benlorenzetti/Breadboard-Oven/Breadboard-Oven.tex

\documentclass[11pt, twocolumn]{article}
\usepackage[margin=1in]{geometry}
\usepackage{graphicx}
\usepackage{microtype}
\usepackage{verbatim}
\usepackage{amsmath}
\usepackage{nicefrac}
\usepackage[colorlinks=false, hidelinks]{hyperref}
\usepackage{caption}
\usepackage{subcaption}
\usepackage{listings}

\title{Report}
\author{Author}
\date{Septembre 2013}

% Definition of \maketitle
\makeatletter         
\def\@maketitle{
\raggedright
\\[8ex]
\begin{center}
{\Huge \bfseries \sffamily \@title }\\[4ex] 
{\Large  \@author}\\[4ex] 
\@date\\[8ex]

\end{center}}
\makeatother

\begin{document}

\maketitle

\section*{Features}

\section*{Introduction}

\section{User Interface}

\section{Oven Design}

\end{document}
