benlorenzetti/Breadboard-Oven/Easy-PCB.pdf

## Easy–PCB Solder Reflow Oven

Ben Lorenzetti

## Figures/easy-pcb-oven.pdf

## Features

- Insulated aluminum frame with XxYxZ interior chamber
- XXX Watt heating element with solid state relay control
- 120 VAC power supply with surge and short protection
- Forced convection fan driven by bipolar stepper motor with speed control
- Type X thermocouple for temperature feedback loop
- PIC18F14K50 based control
- Convenient 7–segment display and pushbutton user interface

## Introduction

Easy–PCB is a small, desktop convection oven for DIY reflow soldering at home.
As integrated circuits continue to become smaller and faster, many µControllers, FPGAs, and other ICs are no longer available in DIP form for breadboard prototyping or iron soldering. Similar to the shift away from PC parallel ports in the early 2000s, the shift away from DIPs means modern electronics hobbyists need more complicated equipment than their predessesors.
Currently, commercial solder reflow stations are available for soldering fine pitch, SMD, and BGA componenets. More recently, several hackers have created open source designs for inexpensive reflow ovens, using converted kitchen toaster ovens. Easy–PCB is better because it is a convection oven; controlled air flow prevents parts from being blown out of position and convection heating obviates the uneven heat absorbtion seen in infrared radiation based systems. Furthermore, Easy–PCB was designed from the ground up for soldering, so the heating elements and oven frame were optimized alongside the temperature controller for a typical solder reflow profile.

Figures/control-system.pdf

The Easy–PCB Control System: not just a controller bolted onto a disjoint oven.

Easy–PCB allows hobbyists to produce reflow temperature profiles with a high degree of accuracy and repeatability. Alongside freely available PCB design programs like Eagle and low-quantity fabrication services like OSH Park, Easy–PCB makes modern integrated components, such as digital CMOS cameras, within the design space of hobbyists and hackers.

Figures/control-results.pdf

Faithful Temperature Profile Control

## Contents

Features | 1
Introduction | 1
1 User Interface | 2
2 Plant Design | 2

2.4 Component Selection & SPICE Modeling 7

3 Temperature Feedback Design | 8
3.1 Controller and Power Requirements . | 9
4 Motor Driver Design | 9
5 Power Circuit Design | 9
6 Controller Design | 9

## 1 User Interface

Easy–PCB presents temperature and time information on a four digit LED display. After pressing the green ‘start’ button, the current temperature and process runtime are alternately displayed every second.

The red ‘stop’ button can be pressed at anytime to quit the current process or reset the microcontroller.

← | →

↑

↓

Start

Stop

Pushbutton Interface

Set point programming with the 4 nav keys is used to enter a time–temperature profile. Use the ‘left’ and ‘right’ keys to move between set points and the ‘up’ and ‘down’ keys to edit each set point value.

0s | 20o | t1 | T1 | t2 | T2 | tn | 20o
| | | | | 275oC

20oC

(tn−1 + 255s)

tn−1

t1 | t2 | tn

T1

T2

T (

oC)

time (s)

Set Point Programming

A total of 128 set points can be entered. The first set point is always (0s, 20oC), and the process will terminate at the next occurance of 20o
in a
point. Temperatures can take any value in the range 20oC < T < 275oC = 527oF. The time between two points must be between 0 <= t < 255 seconds.

## 2 Plant Design

### 2.1 Temperature Objectives

A typical solder reflow profile is shown in figure 1. The optimal shape and peak temperature depend on the components and, more significantly, on the use of

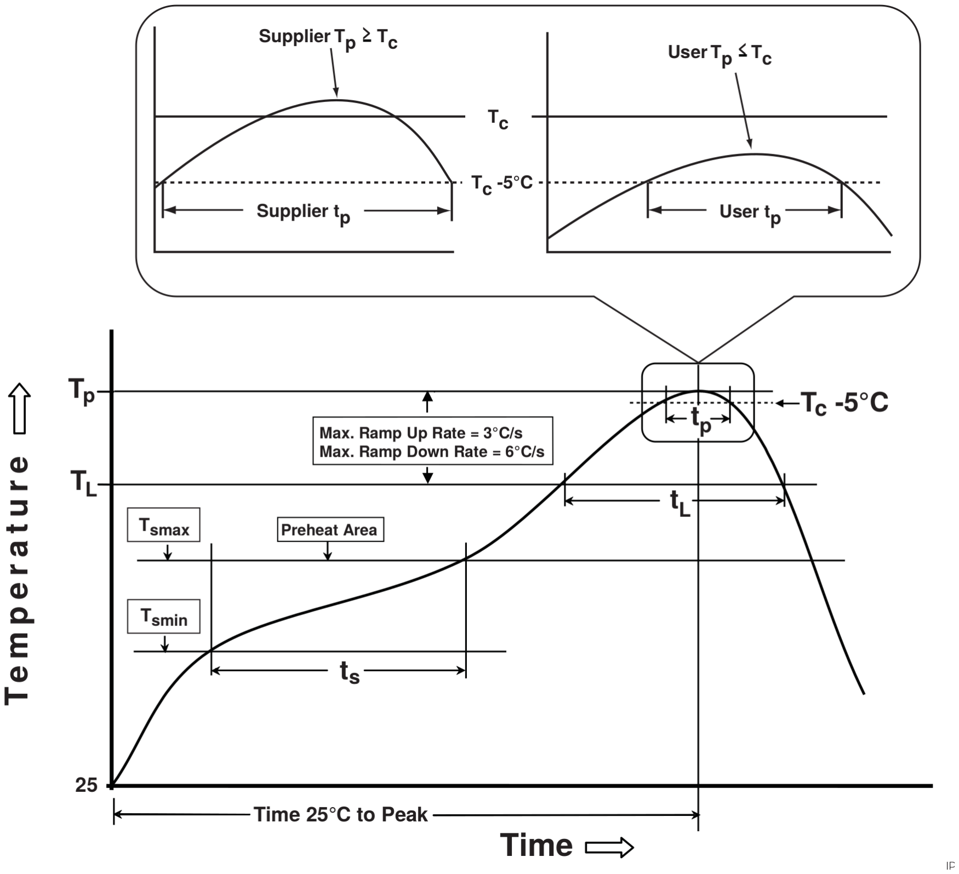
[picture p2: figure]

Figure 1: Standard Solder Reflow Profile, per IPC/JEDEC STD-1-020D.1

leaded solder.

Tp ≈ Tc =

220 − 235oC Leaded solder
245 − 260oC Pb–free

tp =

20s Leaded solder
30s Pb–free

Easy–PCB was designed from the ground up for faithfully producing these reflow profiles. This design process for the thermodynamic system is detailed below.

### 2.2 Thermodynamics Theory

Heat is everyone’s least favorite form of energy because it tends to dissipate everywhere and is difficult to transform into useful work. Nevertheless, it is a form of energy so it is measured in joules.

Q := Heat [Joules]

From a microscopic view, heat is the kinetic energy of gas molecules or the vibrational energy of bonds in solids. In both cases, summed over every molecule, every bond, and every vibrational mode in the system.

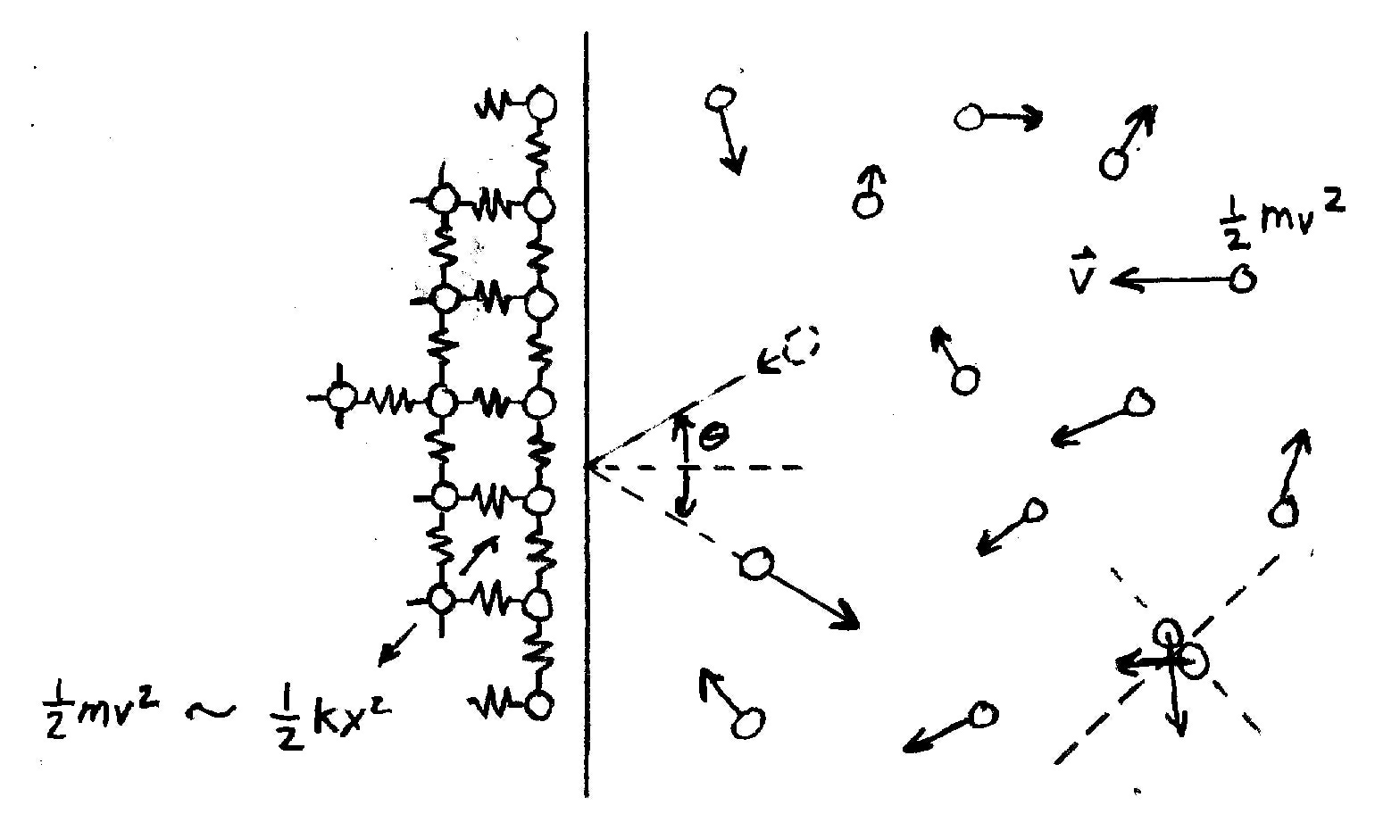
[picture p3: figure]

Figure 2: Heat Energy on a Molecular Scale

Temperature is a potential field that measures an objects tendancy to give up or absorb heat. On average, heat always flows from regions of hotter temperature temperature to lower temperature. Temperature is usually measured in Kelvin or Celsius, which are related by

TCelsius = TKelvin + 273.16.

Another way to think of temperature is a measure of heat density that also incorporates the types of bonds (or lack thereof) in which heat energy is stored.

For example, a glacier contains more heat than a pot of boiling water, but has a much lower heat density. The relationship between temperature and heat stored in an object is given by

dQ = mcpdT, | (1)

where cp is the specific heat of the material with units
h
kJ
kg∗K

i
So heat flows spontaneously to reduce temperature gradients, but how does heat flow and at what rate? There are three mechanisms of heat transfer: conduction, convection, and radiation.
Conduction of heat is caused by molecular interactions, such as the push–pull of nearby atomic bonds in solids or elastic collisions between molecules of air. The empirical relation for conduction is Fourier’s Law, which says the rate of heat transfer due to conduction is proportional to both the difference in temperature and the media:

~q = k∇~ T

where ~q is the rate of heat transfer per unit surface area and k is the thermal conductivity of the medium with units -

W
m∗K
In integral form, Fourier’s Law is

δQ
δt = k

I

S

∇~ T ∗ dA. ~

And, in the one dimensional case,

δQ
δt = −kAδT
δx . | (2)

Convection is the second mechanism of heat transfer, involving the bulk movement of particles driven by diffusion.
Every air molecule is moving in a random direction with random kinetic energy, but a region of air with higher average kinetic energy (temperature) will see more molecules leaving than entering on average, because those leaving are moving faster than those entering.
Note that in convection, no molecules gain or lose energy; molecules of different energy simply trade places.
If a fan is used to apply work to a gas, the rate of convection increases and then Newtons’ Law of Cooling can predict the rate of convection in gas near a solid surface of different temperature.

dQ
dt = hA∆T | (3)

where h is the heat transfer coefficient with units -

W
m²∗K

Radiation, the third mechanism of heat transfer, is more familiar to electrical engineers. In any material, electrons have discrete amounts of energy based on the wave patterns that can exist for the atomic geometry. When an electron spontaneously falls to a less energetic patter, that energy is emitted as a photon of light.

The classic, physics–history example is black body radiation, when a metal is heated to high temperature and glows. A more modern examle is the LED.

The empirical relation for radiation is the Stefan– Boltzmann Law, which says that the total energy radiated, over all wavelengths and per unit surface area, is proportional to the fourth power of the body’s temperature.

j

∗ = σT⁴
(4)

where σ is a proportionality constant derived from other constants of nature.

Mechanisms & Media Usually one mechanism of heat transfer is dominant in a particular medium, so much so that we can ignore the other two. Typically this means conduction in solids, convection in fluids or gas, and radiation in space. However, sometimes the picture is more complicated including two cases in an oven:

1. At the boundary of metal and air, where conduction and convection are both significant.
2. In a thermocouple loop, where thermal diffusion (convection) of electrons is useful despite conduction still being dominant.

### 2.3 Thermodynamic Design

Most microwaves draw between 600 and 1200 Watts of power. An IR toaster oven may draw 1500 Watts into its lamps. How much power does Easy-PCB need to produce the required temperature profiles?

Our approach for answering this question is to browse available parts on McMaster.com, imagine how they would be assembled into an oven, and then model their thermodynamic response using SPICE.

A first conceptual design of Easy–PCB is shown in figure 3.

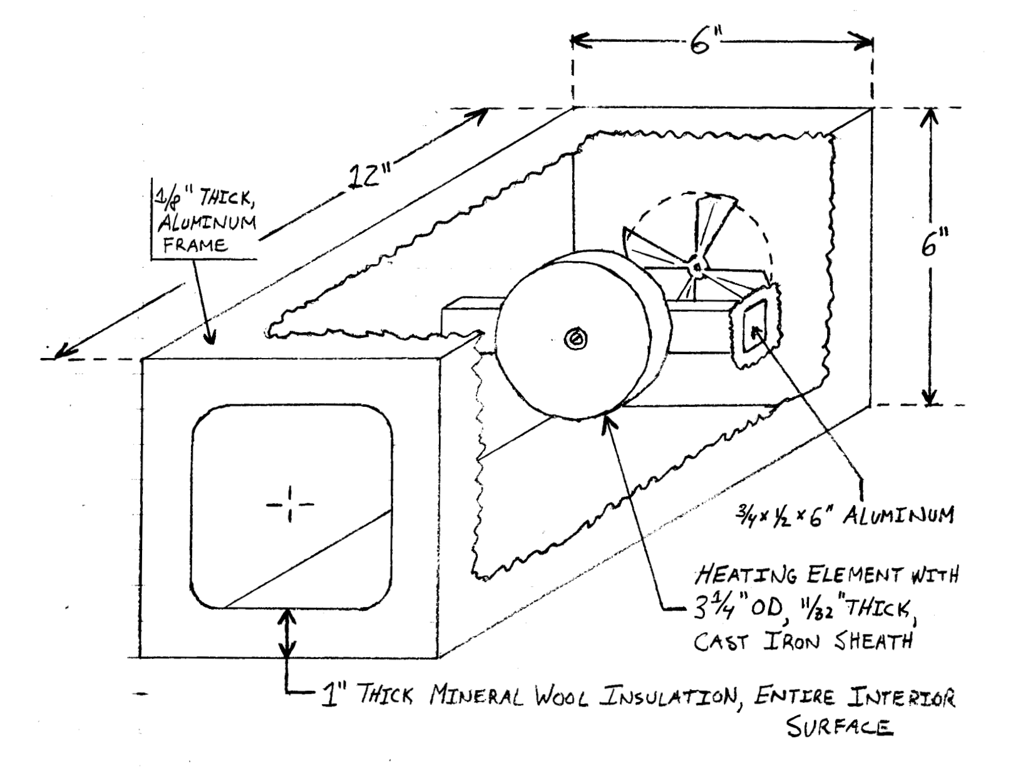
[picture p4: figure]

Figure 3: Concept for Thermodynamic System

Conduction through Metals & Insulation

In the concept, the oven chamber is isolated from the outside with walls of mineral wool insulation and aluminum. If the wall is relatively thin compared to the square root of its surface area, then its heat transfer can be modeled as a 1–D transmission line, like shown in figure 4.

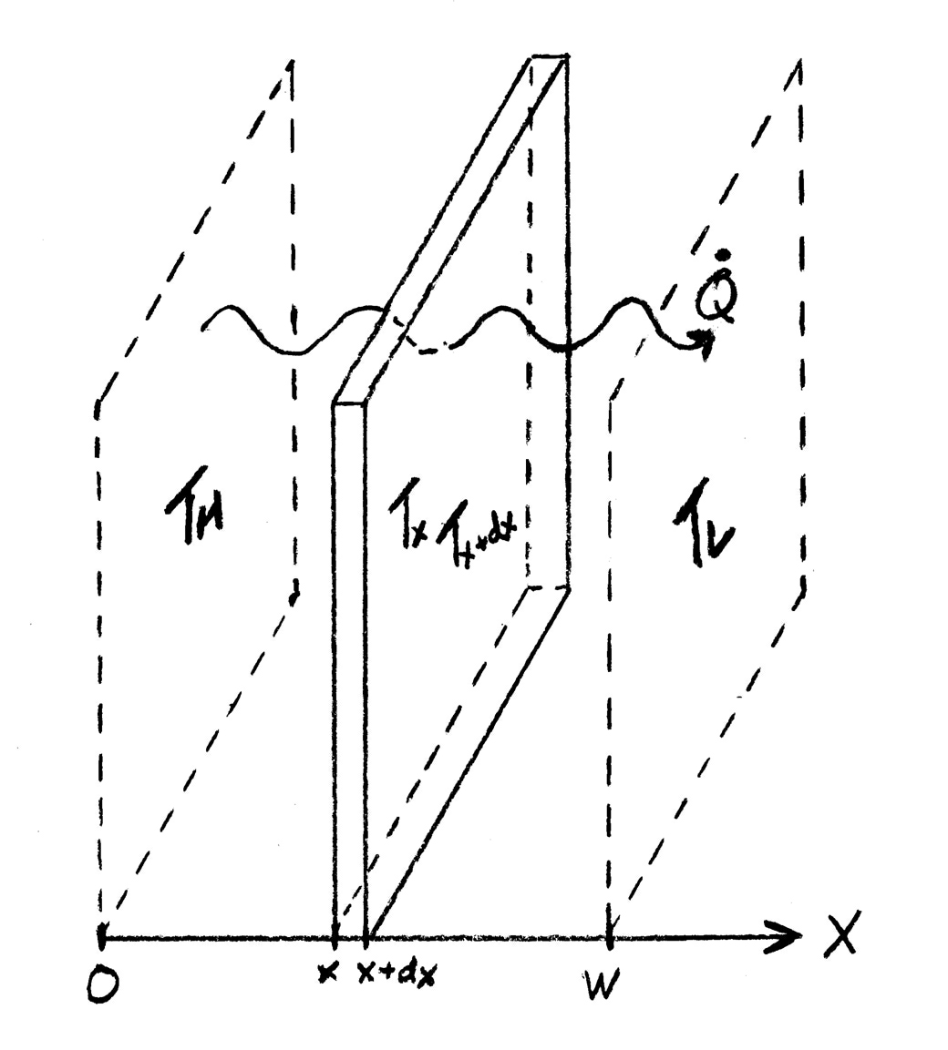
[picture p5: figure]

Figure 4: Heat Conduction in 1–D

Assuming conduction is the dominant mechanism of heat transfer and using Fourier’s Law in 1–D, (equation 2) the rate of heat passing through a thin slice is
δQ
δt = −kAδT
δx

And, from equation 1, the heat capacity of a thin slice of the metal sheath is

dQ = (ρAdx)cpdT

Rewriting these equations to look like currentvoltage relationships gives

δT = Rx

δQ
δt , Rx =

δx
| kA | (5)

and
δQ
δt = Cx

δT
δt , | Cx = ρAcp ∗ δx | (6)

Values for thermal conductivity k, specific heat capacity cp, and density ρ of different materials are listed in table 1.
Long metal bars and rods can also be modeled with equations 5 and 6 if the heat loss along the length of the bar is assumed to be negligible compared to heat transfered at the end faces.

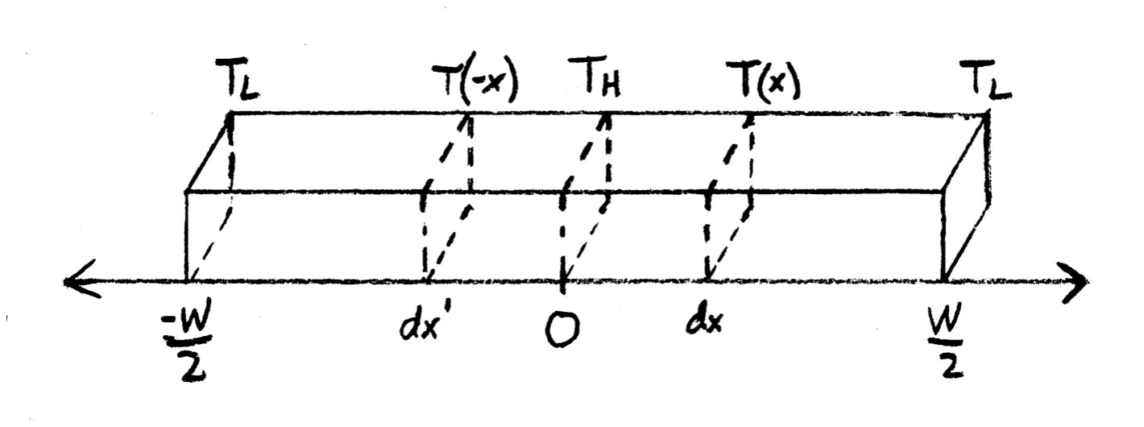
[picture p6: figure]

Figure 5: 1–D Conduction in Both Directions

For metal components where heat is injected at the center of the part and dissipates symmetrically in either direction, such as the support bar shown in figure 5 or the metal sheath encasing the heating element, the surface area can be doubled so that the transmission line only needs to be integraded in the positive direction.

Ax | ⇒ | 2Ax
Rx | ⇒ | Rx/2
Cx | ⇒ | 2Cx
{x| − w
2 ≤ x ≤

w
2

} ⇒ {x|0 ≤ x ≤

w
2

}

(7)

Conductivity of Metal–Air Interface

In the bulk volume of air, convection is the dominant form of heat transfer and collisions are relatively rare. However, where the air meets a solid surface, the net convection must go to zero because there can be no net movement of air molecules into the solid. Furthermore, every air molecule that reaches the surface experiences a collision so there is 100% conduction at the surface. For some distance away from the surface, there is a larger than normal chance of head–on collisions and slower rates of diffusion due to the nearby wall. In

Table 1: Thermal Conductivity, Specific Heat, and Density of Selected Materials

Material | Linear Range (oC) | k

W
m∗K
cp
kJ
kg∗K
ρ (kg/m³
)
Type 6061 Aluminum | 25 | 167 | 0.896 | 2700
Type 304 Stainless Steel | 0–100 | 16.2 | 0.5 | 8000
Cast Iron | 25 | 55.0 | 0.46 | 6800–7800
1.0 K–factor Insulation | - | 0.1442 | - | -
0.23 K–factor Insulation | - | 0.0332 | - | -
Nichrome NiCr C Alloy | - | 0.450 | 0.135 | 8244

this region, both conduction and convection may be significant. To analyze this transition region, we will start at the surface where there is 100% conduction because that is the mechanism we have equations for. From the first law of thermodynamics, the rate of heat being stored in a differential volume is equal to the rate of heat entering less the rate of heat leaving the volume element.

δQstored
δt =

δQin
δt −

δQout
δt

Looking back at figure 4, the differential volume element is a plane, so

δQstored
δt =

δQx
δt −

δQx+δx
δt .

Substituting in equation 1 for stored heat capacity and equation 2 for conduction through the element yields a transport equation.

mcp

δT

δt = kAδT
δx | (8)

This cannot be solved analytically unless space and time are independent. Sorry Albert.

T(x , t) = Tx(x) ∗ Tt(t) | (9)

Applying the chain rule to equation 8

mcp

δTt(t)

δt Tx(x) = kAδTx(x)
δx Tt(t)

and separating variables gives

mcp

δTt(t)
δt ∗

1
Tt(t)

= kAδTx(x)
δx ∗

1
Tx(x)

The only way for the equality to be true for all space and time is if both sides are equal to a common constant.
α = mcp

δTt(t)
δt ∗

1
Tt(t)

α = kAδTx(x)
δx ∗

1
Tx(x)

Each of these can be solved by separation of variables.
α
kAδx =

δTx(x)
Tx(x)

α

kA Z
δx =

Z
1
Tx(x)

∗ δTx(x)

αx
kA = ln (Tx(x)) + β1

Tx(x) = β

0
1

e

αx/kA

Similarly for time,

Tt(t) = β

0
2

e

αt/mcp

Recombining the independent components gives

∆T(x , t) = β

0
1β

0
2

e

αx/kA+αt/mcp

The boundary conditions are that at t = 0 and x = 0, the temperature difference is the initial temperature difference, and at t → ∞ and x → ∞, the temperature difference dissipates to zero.

∆T(x , t) = ∆T0e

−αx/kA−αt/mcp

Now, for the sake of physical intuition we can write

∆T(x , t) = ∆T0e

−(x/δ+t/τ)
, | (10)

where δ is a ‘skin depth’ over which the spacial gradient decays to 1/e its initial value and τ is a time constant related to the skin depth by

τ =

mcp
kA δ. | (11)

Make some arguments and plot the temperature and heat transfer curves. Assume steady state and somehow that active cooling makes it all valid. Applying Fourier’s law to the temperature profile found in equation 10, gives us the rate of heat trasfer in the air due to conduction.

dQ
dt = −kAdT
dx =

kA
δ

∆T0e

−(x/δ+t/τ)

Table 2: Typical Convective Heat Transfer Coefficients

| Fluid | Conv. | hc - W m²∗K
Gases, & dry vapors | free | 0.5 − 1000
| | forced | 10 − 1000
Water & liquids | free | 50 − 3000
| | forced | 50 − 10000
Boiling Water | - | 3 − 100
Condensing H2O Vapor | - | 5 − 100

Table 3: Thermal Properties of Air

T [

oC] ρ

h
| kg m³

i
cp

h
| | kJ kg∗K

i
| | | k - W m∗K
20 | 1.205 | 1.005 | 0.0257
40 | 1.127 | 1.005 | 0.0271
60 | 1.067 | 1.009 | 0.0285
80 | 1.000 | 1.009 | 0.0299
100 | 0.946 | 1.009 | 0.0314
120 | 0.898 | 1.013 | 0.0328
140 | 0.854 | 1.013 | 0.0343
160 | 0.815 | 1.017 | 0.0358
180 | 0.779 | 1.022 | 0.0372
200 | 0.746 | 1.026 | 0.0386
250 | 0.675 | 1.034 | 0.0421
300 | 0.616 | 1.047 | 0.0454

Again assuming steady state, the rate of heat trasfer at any distance from the wall is equal to the rate of conduction at the wall.

dQ
dt =

kA
δ
∆T0 = hcA∆T0 | (12)

This is the information we were after and, ironically, it turns out this is Newton’s Law of Cooling (equation
3) where hc = k/δ. Since we do not have any way of predicting the skin depth except by experimentation, some common values for the convective heat transfer coefficient hc are listed in table 2.
Equation 12 can be rewrittent to look like Ohms’ law for SPICE analysis.

∆T = Rc

dQ
dt , Rc =

1
hcA

=

δ
kA (13)

Heat Capacity of Chamber Air

The heat capacity of the air in the chamber cannot be analyzed with constant coefficient assumptions.

dQ = m(T)cp(T)dT | (14)

From table 3, we can see that the specific heat of air does not vary much over the temperature range of the oven; less than 0.3% from cp(20oC) over the range

20 − 300oC. However, the density and mass of air in the chamber may change significantly.
Assuming that the air in the chamber behaves like an ideal gas and is made up of the normal percentages of N2, O2, CO2, etc., then mass and temperature are related by

P V =

m
M
RT | ⇒ | m(T) = MP V R
T

where the ideal gas constant is

R = 5.00745

| | atm ∗ in³
| | mol ∗ K

and the molar mass of air is

M = 28.97 h

g
mol

i

For the first oven concept in figure 3, the volume of the chamber is fixed in natural units of in³ and there are likely small leaks that let the chamber pressure equilibrate to atmospheric pressure 1 atm. Substituting m(T) into equation 14, converting from absolute Kelvin scale to Celsius, and manipulating to look like a current–voltage relationship results in
dQ
dt = Cc(T)

dT
dt | (15)

where
Cc(T) = cp(20oC)MP V
R(T + 273.16oC)
. | (16)

Equivalently,

Cc(T) =

5.8143 -

J
in³

∗ V
T + 273.16oC

### 2.4 Component Selection & SPICE

Modeling

Unfortunately, SPICE does not have a primitive circuit element for a variable capacitor. In order to simulate the heat capacity of an ideal gas, we must build a subcircuit that behaves according to

ic = C(vc)

dvc
dt ,

or, alternatively,
Z
icdt =

Z
C(vc)dvc. | (17)

The interface of the SPICE circuit will be a dependent source where either vc is dependent on ic or vice versa.
The left side of equation 17 is an integrator, which can be implemented with a buffer and a capacitor. For the SPICE circuit shown in figure 6, the integrated current is proportional to the voltage of the ‘int’ node.
Z
icdt = Cint ∗ vint

Figures/variable-capacitance-circuit.pdf

Figure 6: Voltage Variable Capacitor in SPICE

For the right side of equation 17, it can be solved for the variable heat capacitance of an ideal gas found in equation 16.
R
C(vc)dvc =

cpMP V
R

R

dvc
vc+273.16
| =

cpMP V
R

ln(vc + 273.16) + A

Recombining the left and right halves gives

Cintvint =

cpMP V
R

ln(vc + 273.16) + A,

which can be solved to find a nonlinear expression for a dependent source vc.
Solving...

RCint
cpMP V

∗ vint = ln(vc + 273.16) + A

vc = A

0
e

vint/B − 273.16

Finally, applying boundary conditions vc(0) = 0 and vint(0) = 0 gives

vc = 273.16
e

vint/B − 1

(18)

where constant B is

B =

cpMP
R

∗ V ∗ Cint

=

5.8413 -

J
in³

∗ V ∗ Cint

(19)

and V is the constant volume of air.

Table 4: Nichrome Wire Properties (NiCr C)

Composition | 59.2%Ni | 16%Cr | 23.5%Fe | 1.3%Si
Resistivity (ρ) | 675 ∗ π

h
| | Ω∗mil²
f t | i
Melting Pt. | 1350 | [ oC]
Temp. [oC] | 20 | 93 | 204 | 315
% ρ Increase | 0 | 1.7 | 3.5 | 5.2

### 2.5 Transfer Model

## 3 Temperature Feedback Design

The Seebeck voltage is the electromotive force that develops in a conductive loop made of two different metal alloys. It is described by

| ES =

Z T

| T R
αA,BdT, | (20)

where T and TR are the temperatures of the hot and cold junctions and αA,B is the Seebeck coefficient between materials A and B.
A type–K thermocouple was selected because they are readily available and resist oxidation at temperatures up to 1260oC. From the ‘Manual on the use of Thermocouples in Temperature Measurement’ (STP 470A), the nominal Seebeck coefficients for type– K thermocouples is

αKP,KN =

0

oC 39.4 µV /oC
200oC 40.0 µV /oC
400oC 42.3 µV /oC

. (21)

The positive wire KP is one of the following alloys: Chromel, Tophel, T–1, or ThermoKanthal KP. The negative wire KN is Alumel, Nial, T–2, or ThermoKanthal KN.
The thermoelectric potential in a K loop is very small; for a temperature difference of T −TR = 500oC, the voltage developed is only on the order of ES = 20 mV . Consequently, the signal needs to be amplified before it can be read by and ADC. The op amp circuit shown in figure 7 can be used.
Five volt µcontrollers usually have ADC ranges of 0–3.3 V. To scale 20 mV to 3.3 V and 0 V to 0 V , the feedback resistors should be

VADC(max)

VK(max)

=

R2
R1

(22)

3.3 mV
20 mV

= 165

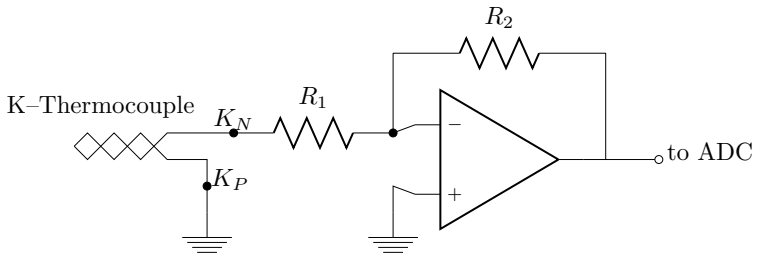
[picture p7: figure]
to ADC; K–Thermocouple

Figure 7: Thermocouple Amplifier

### 3.1 Controller and Power Require-

ments

## 4 Motor Driver Design

### 4.1 Power Requirements

## 5 Power Circuit Design

### 5.1 PCB Trace Width

The minimum width and clearance for high current, high voltage traces on a PCB can be calculated using

I = 0.048[A] ∗

∆T
[

oC]

0.44
∗
A
[mil²]

0.725
(23)

and

Clearance = 0.023[in] + 0.0002[in]
[V ]

∗ Vpeak (24)

from the design standard for PCB trace width ANSI/IPC–2221. Note that equation 23 is only for exterior traces.
For 10 A, 120 V AC power with a maximum temperature rise of 10oC and standard copper thickless 1 oz = 1.4 mil, the minimum trace width is 0.278 in and minimum clearance is 0.057 in.

## 6 Controller Design
