benlorenzetti/Breadboard-Oven/Figures/aluminum-frame-concept.pdf

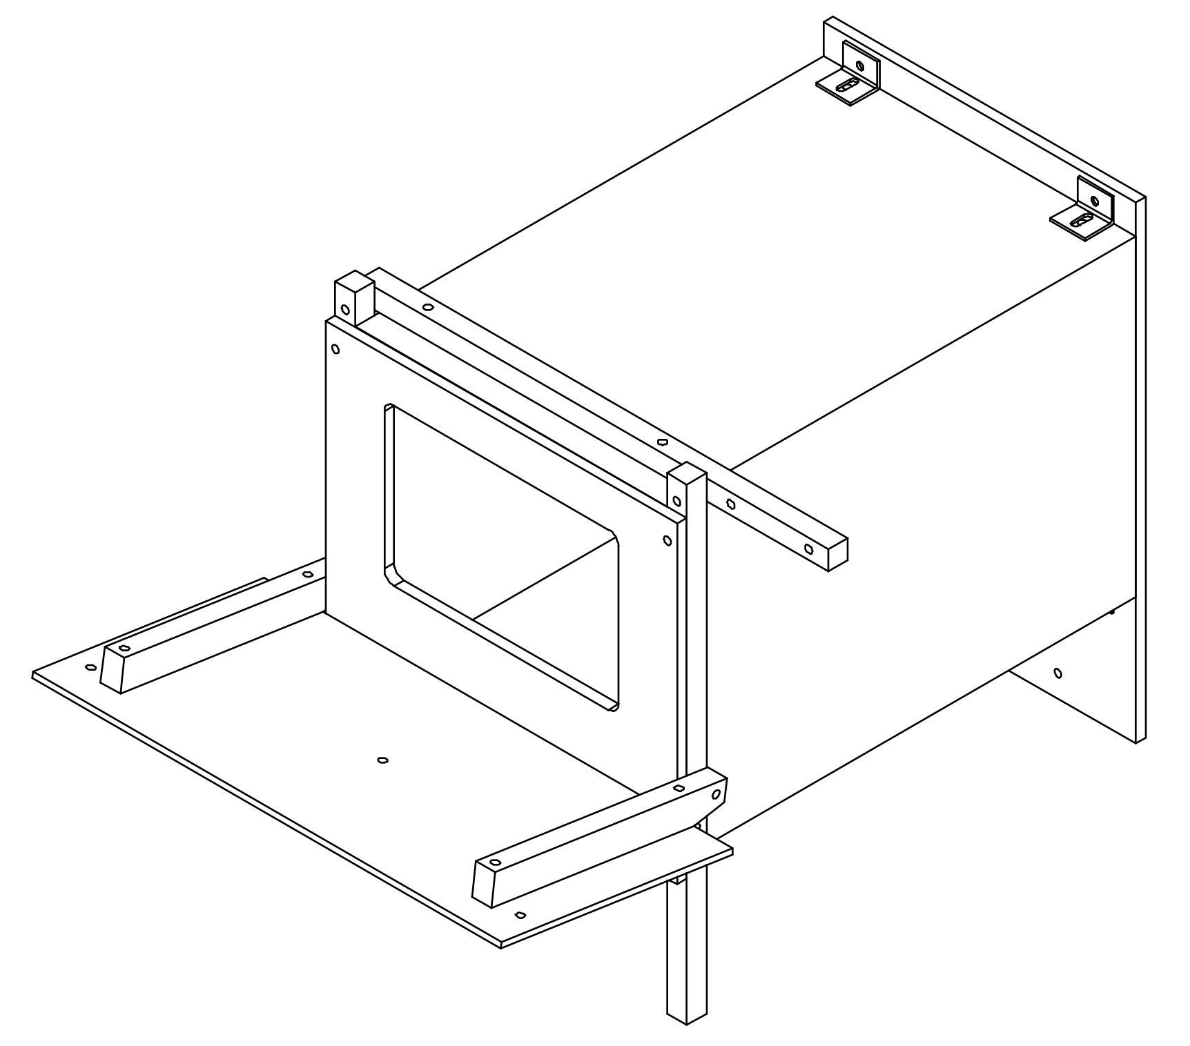
[picture p8: page 1]
