benlorenzetti/Breadboard-Oven/Figures/heating-element-concept.pdf

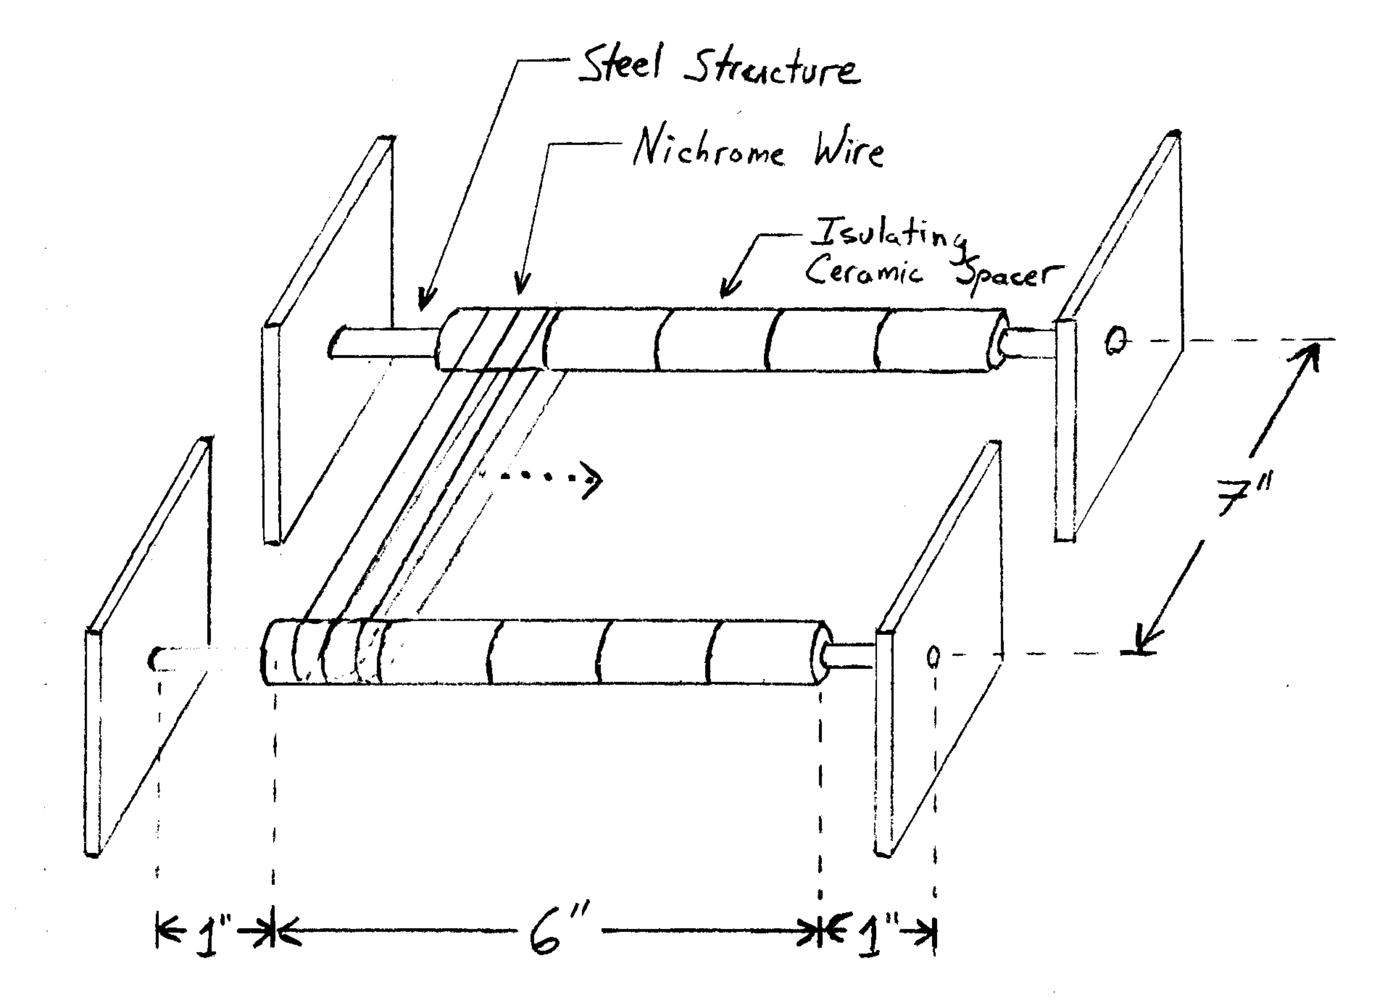
[picture p9: page 1]
