benlorenzetti/Breadboard-Oven/Figures/pic16f883-circuit.pdf

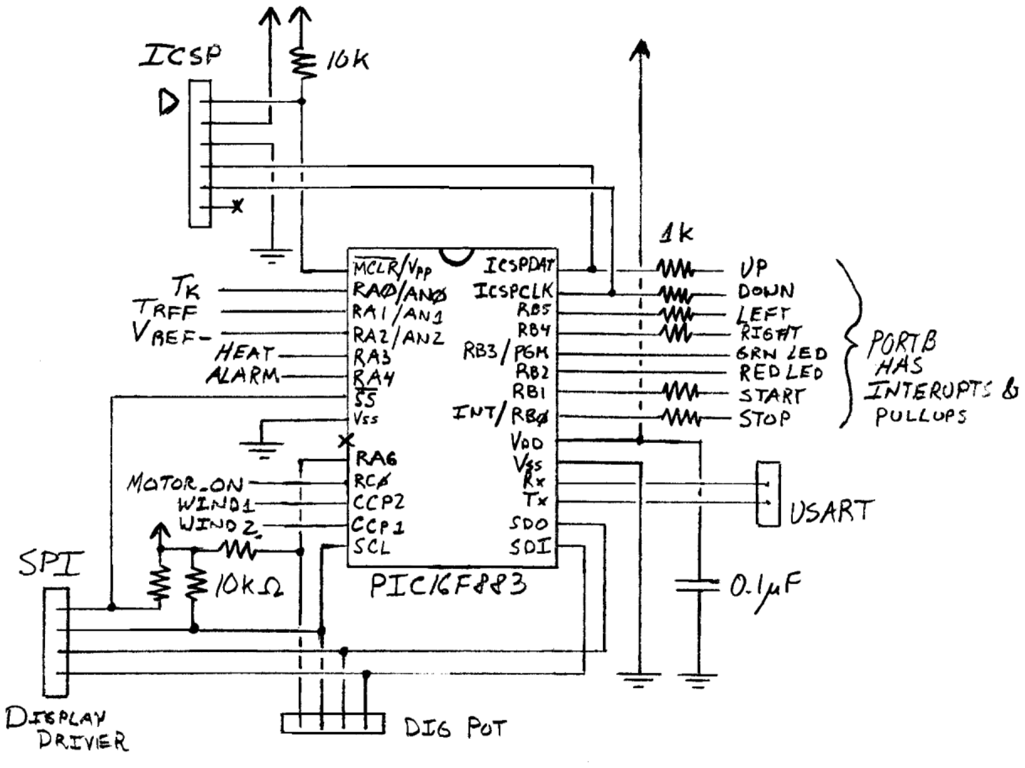
[picture p10: page 1]
