benlorenzetti/Breadboard-Oven/Figures/pushbutton-circuit.pdf

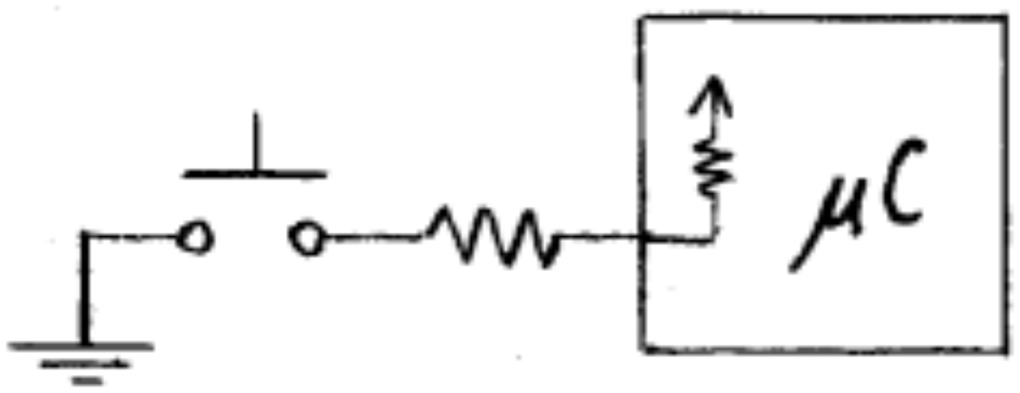
[picture p11: page 1]
