benlorenzetti/Breadboard-Oven/Figures/control-system.pdf

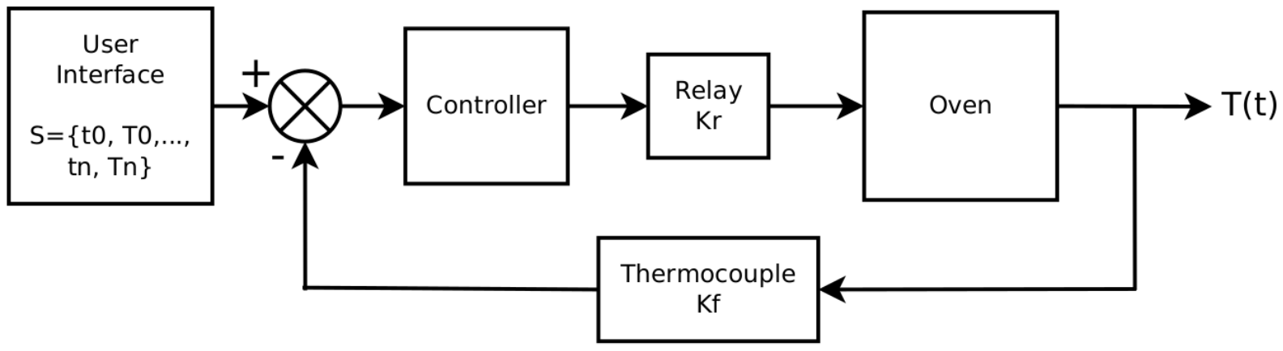
[picture p12: page 1]
