benlorenzetti/Breadboard-Oven/Figures/motor-driver-circuit.pdf

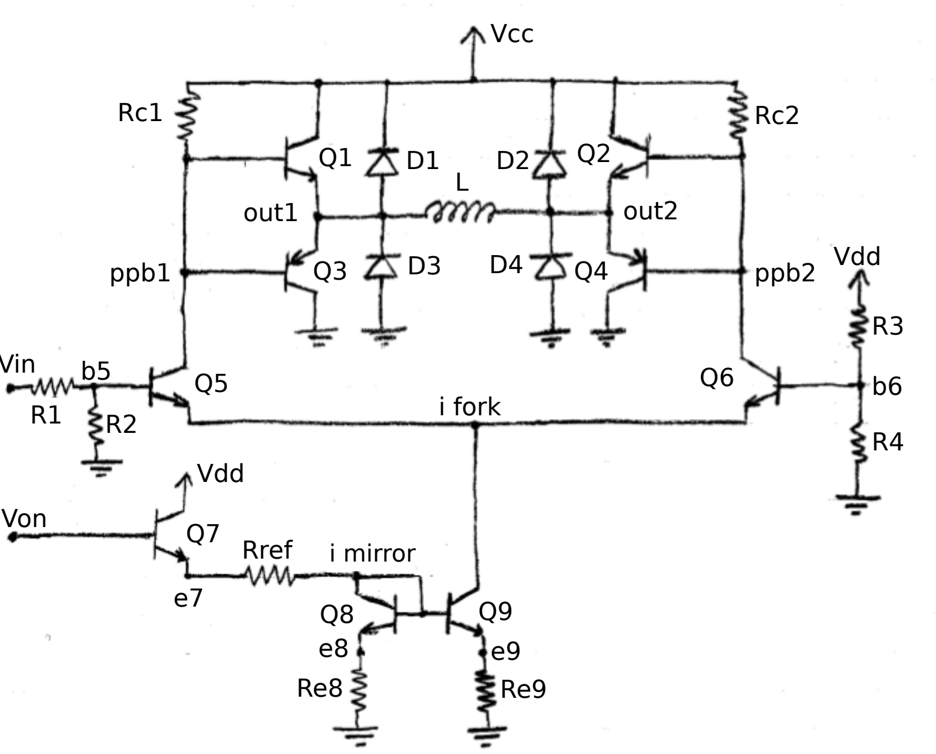
[picture p13: page 1]

Rc2

ppb2

Q6 | b6 R3

Vdd

R4

Q5 b5
R2 R1

Vin

Von | Q7

Vdd

Rref | i mirror
Q8 | Q9
e8

e7

e9
Re8 | Re9

Vcc

out1 | out2

i fork

L

D1 | D2
D3 | D4

Q2

Q3 | Q4

Q1

ppb1

Rc1
