benlorenzetti/Breadboard-Oven/Figures/thermocouple-amplifier.pdf

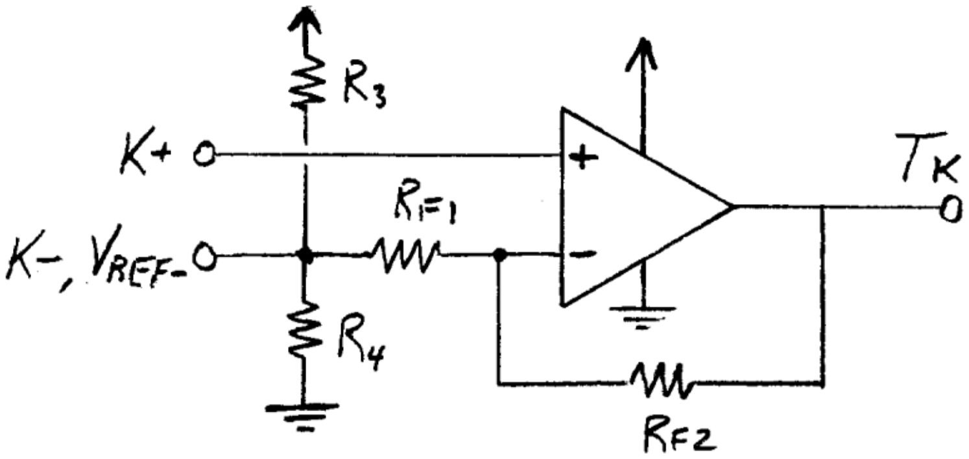
[picture p14: page 1]
