benlorenzetti/Breadboard-Oven/Figures/relay-drive-circuit.pdf

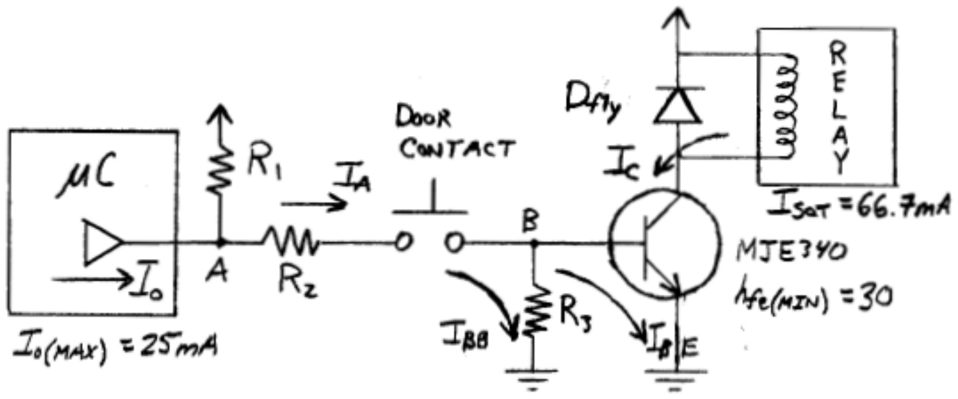
[picture p15: page 1]
