benlorenzetti/Breadboard-Oven/Figures/control-flowchart.pdf

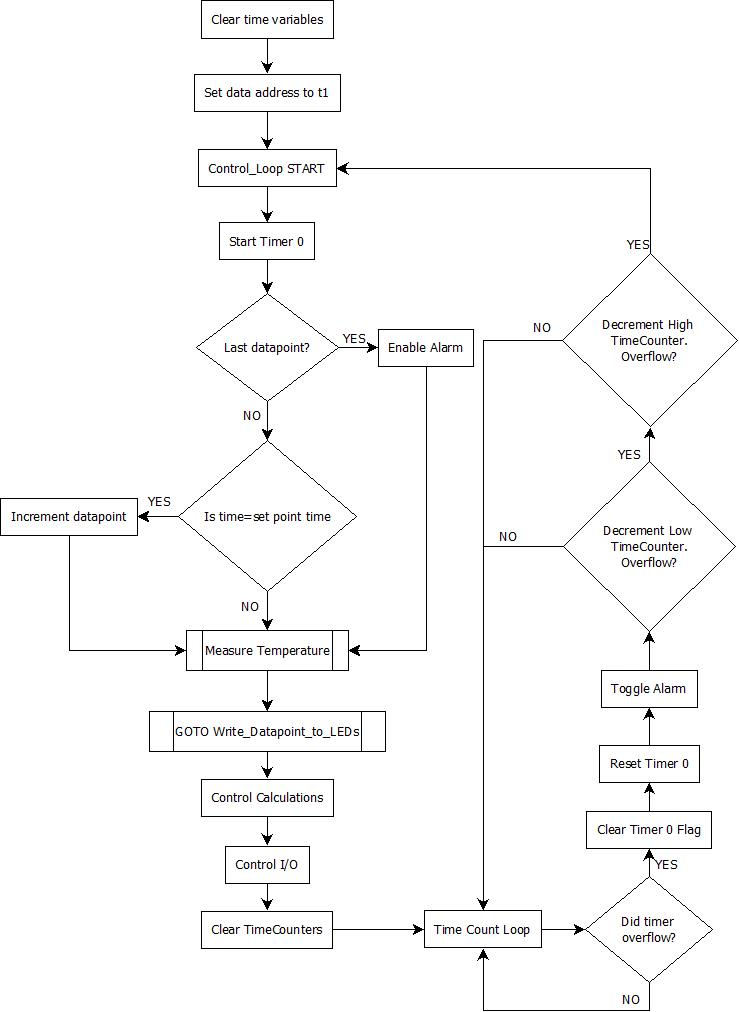
[picture p16: page 1]
