benlorenzetti/Breadboard-Oven/Figures/user-interface-flowchart.pdf

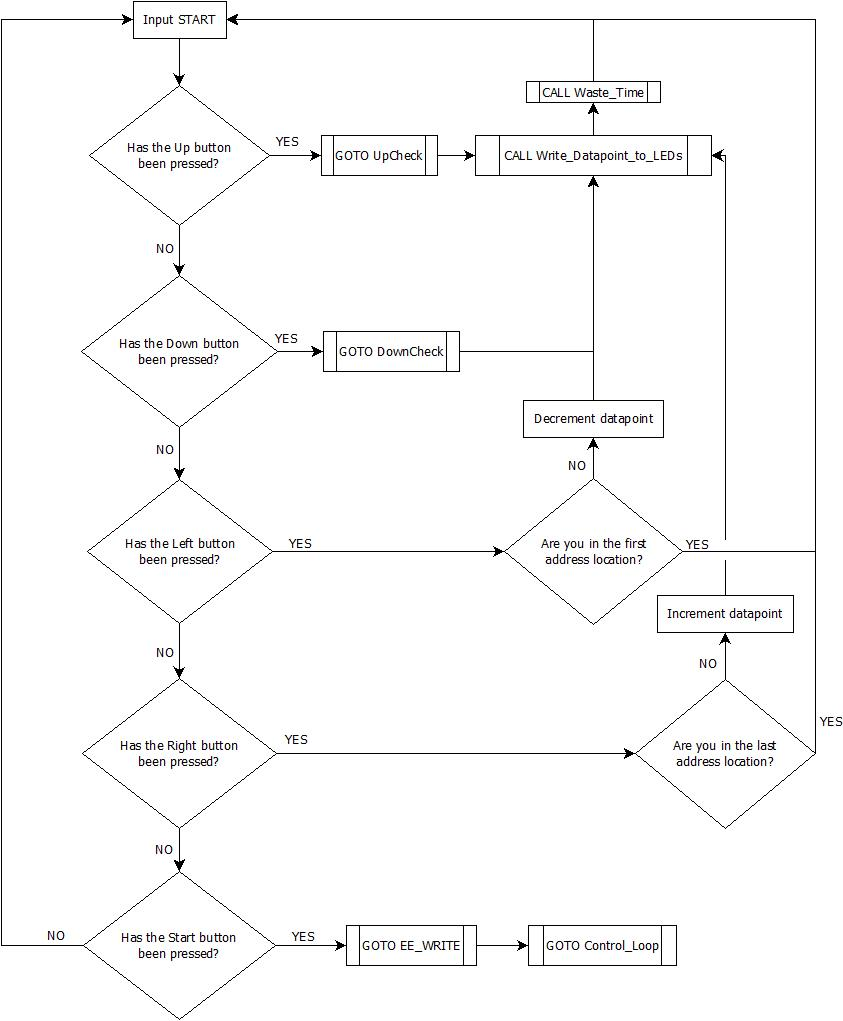
[picture p17: page 1]
