benlorenzetti/Breadboard-Oven/Figures/thermodynamic-spice-circuit.pdf

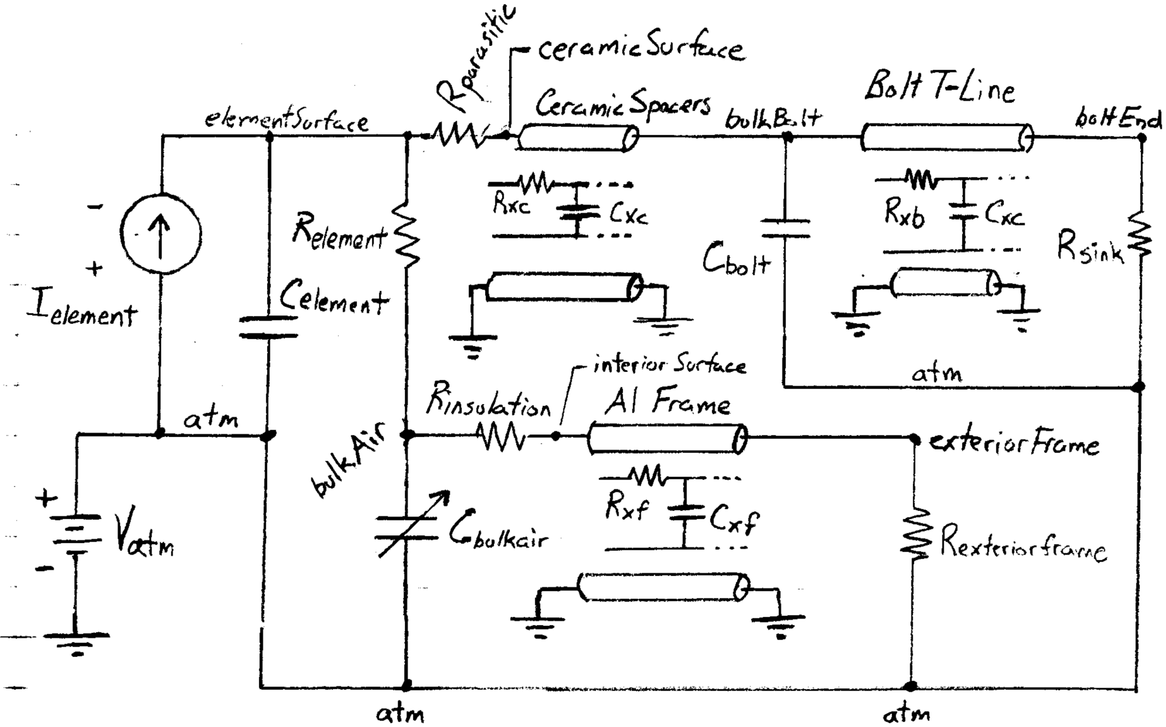
[picture p18: page 1]
