benlorenzetti/Breadboard-Oven/Figures/bipolar-motor.pdf

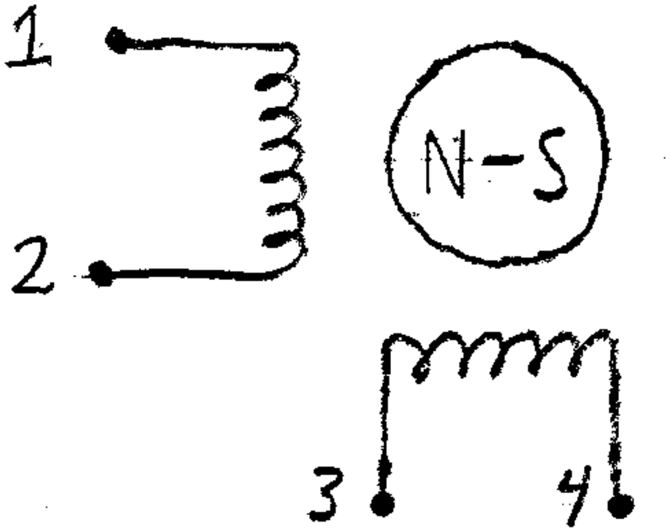
[picture p19: page 1]
