benlorenzetti/Breadboard-Oven/Figures/motor-driver-current-simulation.pdf

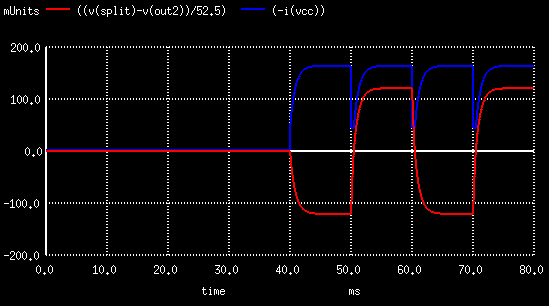
[picture p20: page 1]
