benlorenzetti/Breadboard-Oven/Figures/motor-driver-voltage-simulation.pdf

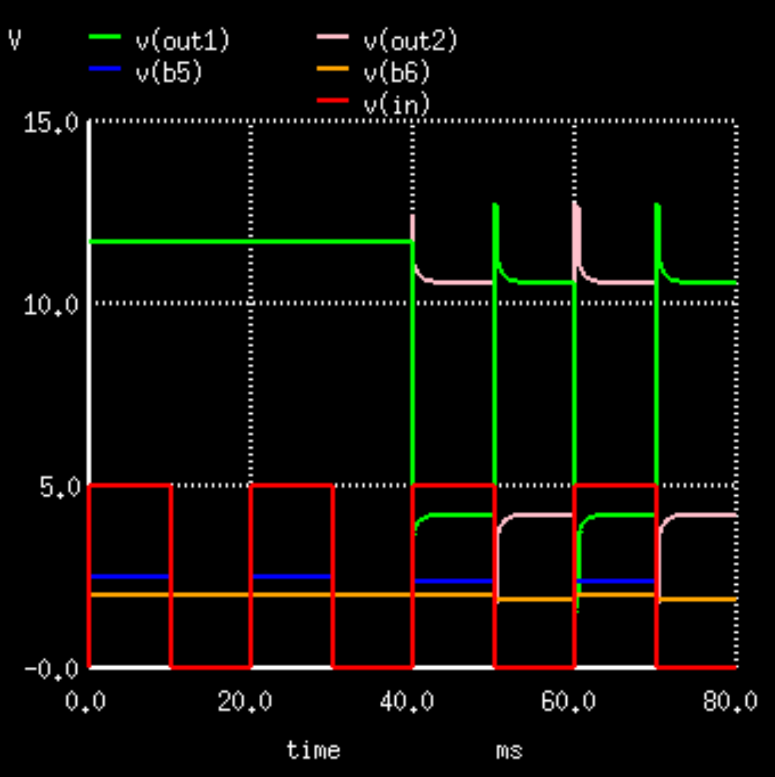
[picture p21: page 1]
