benlorenzetti/Breadboard-Oven/Figures/bidirectional-conduction.pdf

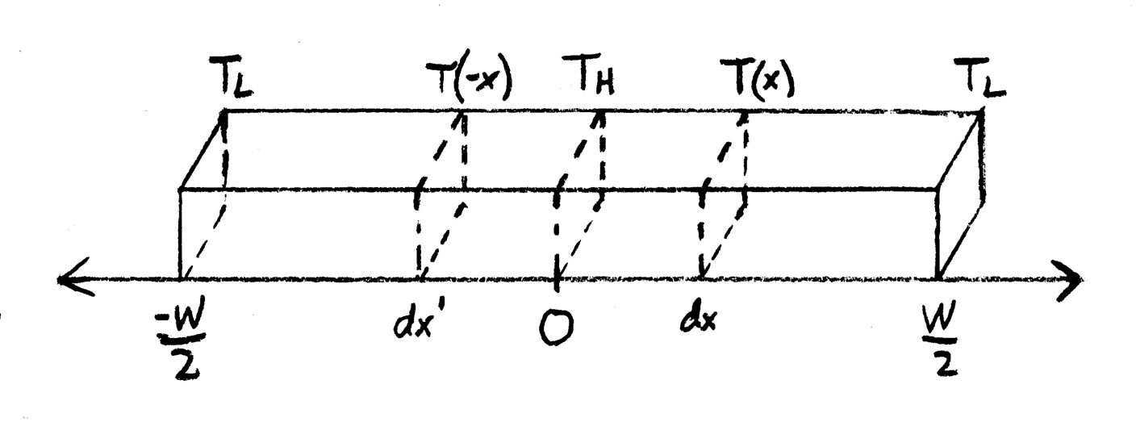
[picture p22: page 1]
