benlorenzetti/Breadboard-Oven/Figures/clock-display.pdf

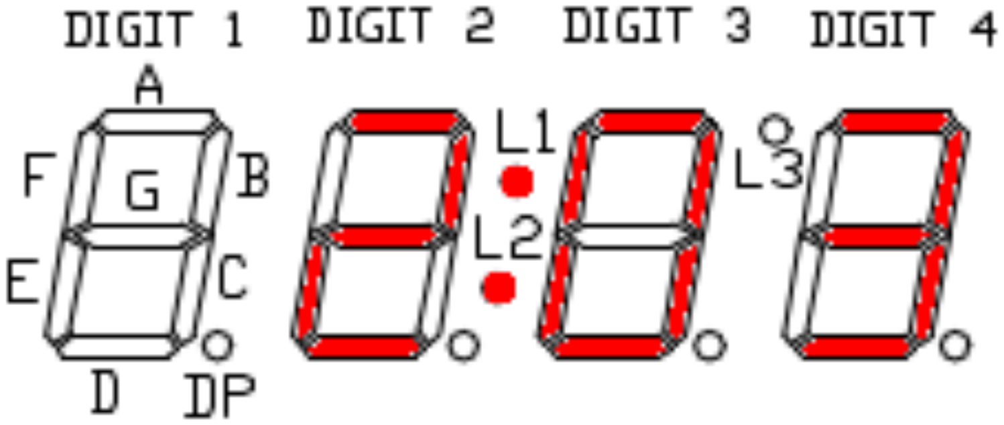
[picture p23: page 1]
