benlorenzetti/Breadboard-Oven/Figures/power-circuit.pdf

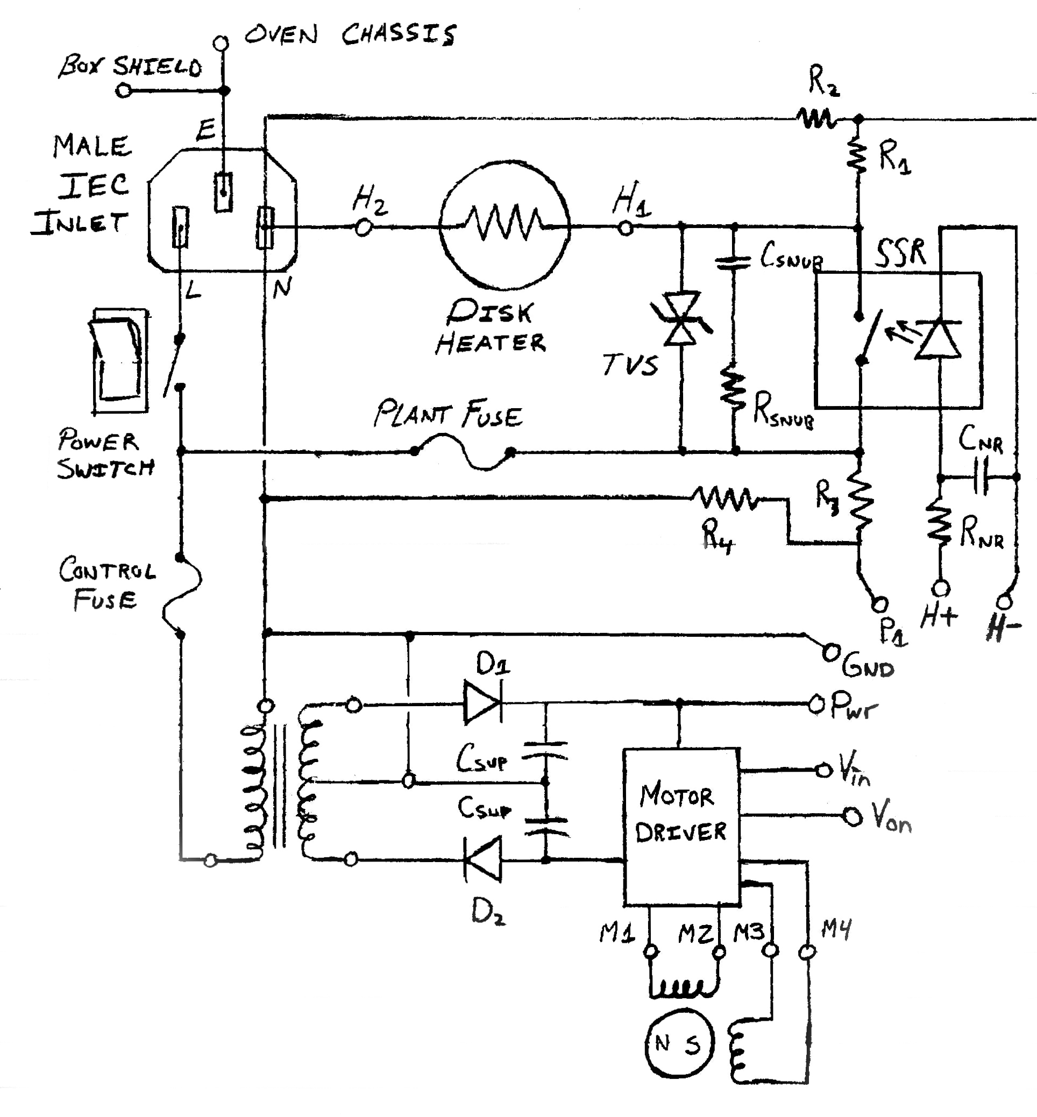
[picture p24: page 1]
