benlorenzetti/Breadboard-Oven/Figures/standard-reflow-profile.pdf

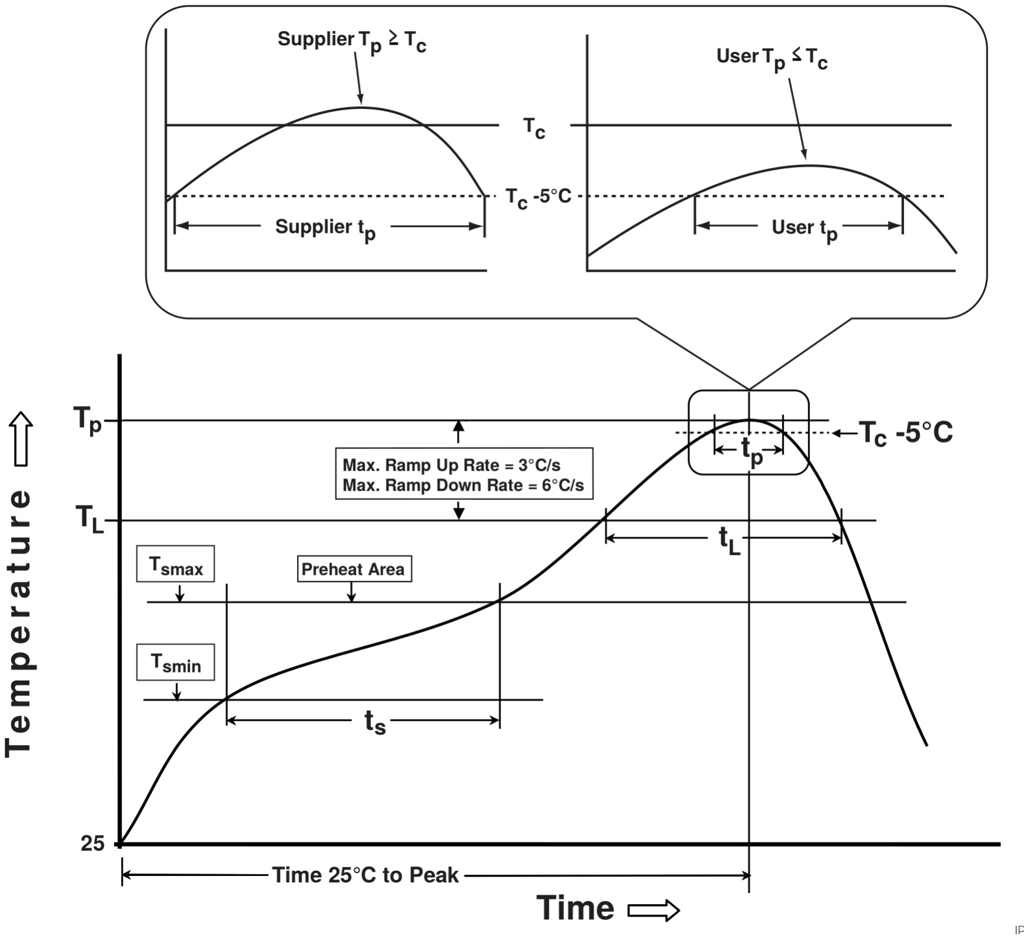
[picture p25: page 1]
