benlorenzetti/Breadboard-Oven/Figures/temperature-display.pdf

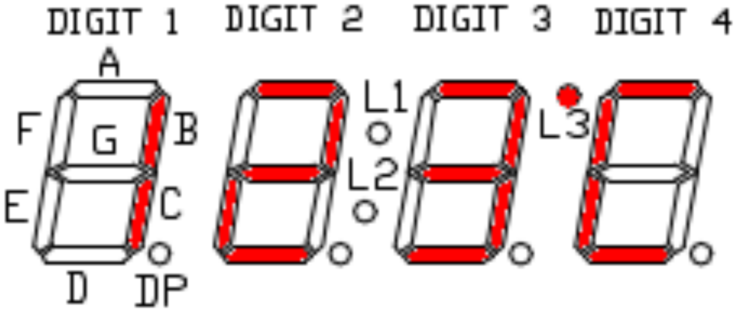
[picture p26: page 1]
