benlorenzetti/Breadboard-Oven/Figures/motor-driver-current-simulation.png

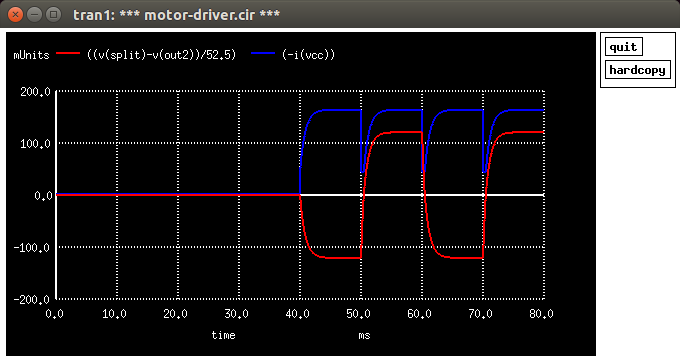
Figures/motor-driver-current-simulation.png
