benlorenzetti/Breadboard-Oven/(list of files, cad)

Other CAD files:
DraftSight/Fan-Drive.dwg
