benlorenzetti/Breadboard-Oven/Figures/control-results.pdf

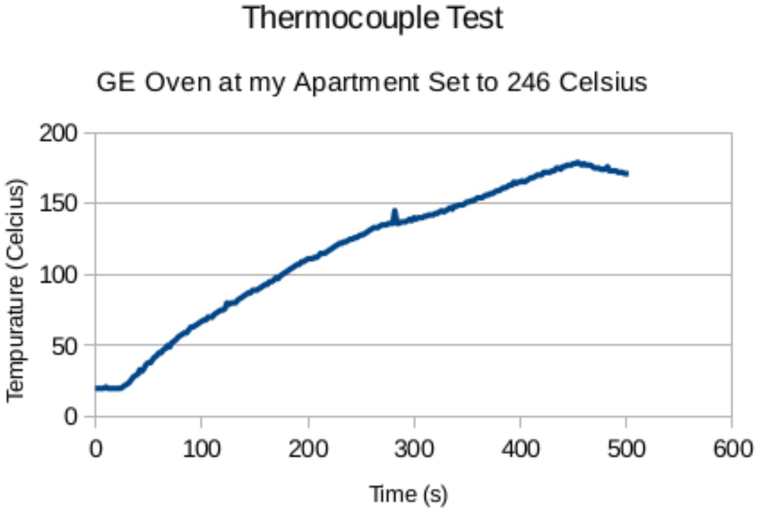
[picture p28: page 1]
