benlorenzetti/Breadboard-Oven/Figures/heat-model-results.pdf

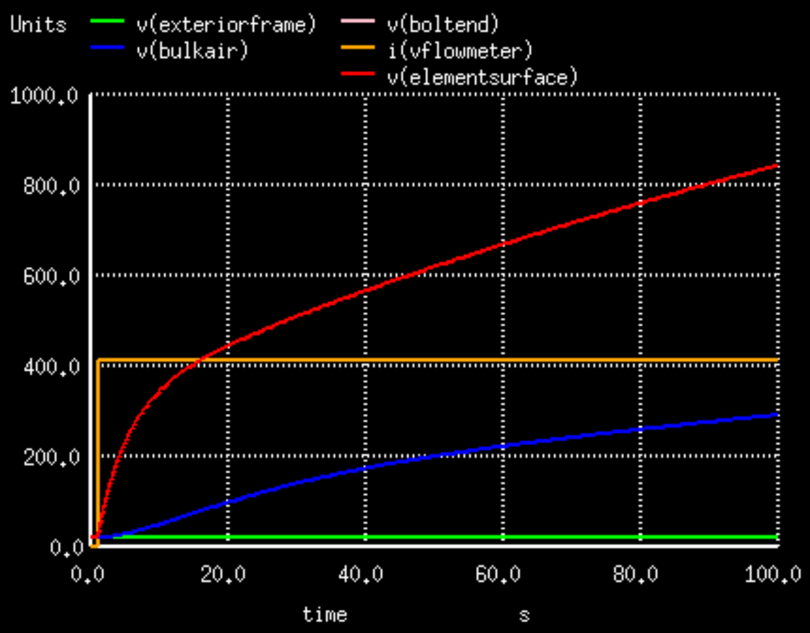
[picture p29: page 1]
