benlorenzetti/Breadboard-Oven/TODO.txt

Fuseholders are incomplete with out corresponding fuseholder cap: Littelfuse Part # 83700000005

Thru-holes on front facing PCB for SW1-7 are all too tight.

Eliminate Pushbuttons except for stop in favor of rotary encoder with color leds

Decrease separation of thru-hole lines for Display driver package

Resistor Calculations for temperature feedback amplifiers

Section on electric circuit for nichrome wire temperature integrator

Add connectors for thermocouple and screw terminal for heater and chassis ground

Back/Motor Mechanical Drawing

Front/Door/Contact Block Mechanical Drawing

Door Mechanical Drawing

Front Mechanical Drawing

Back Mechanical Drawing
