benlorenzetti/Breadboard-Oven/Drawings/Driver-PCB-Drawing.pdf

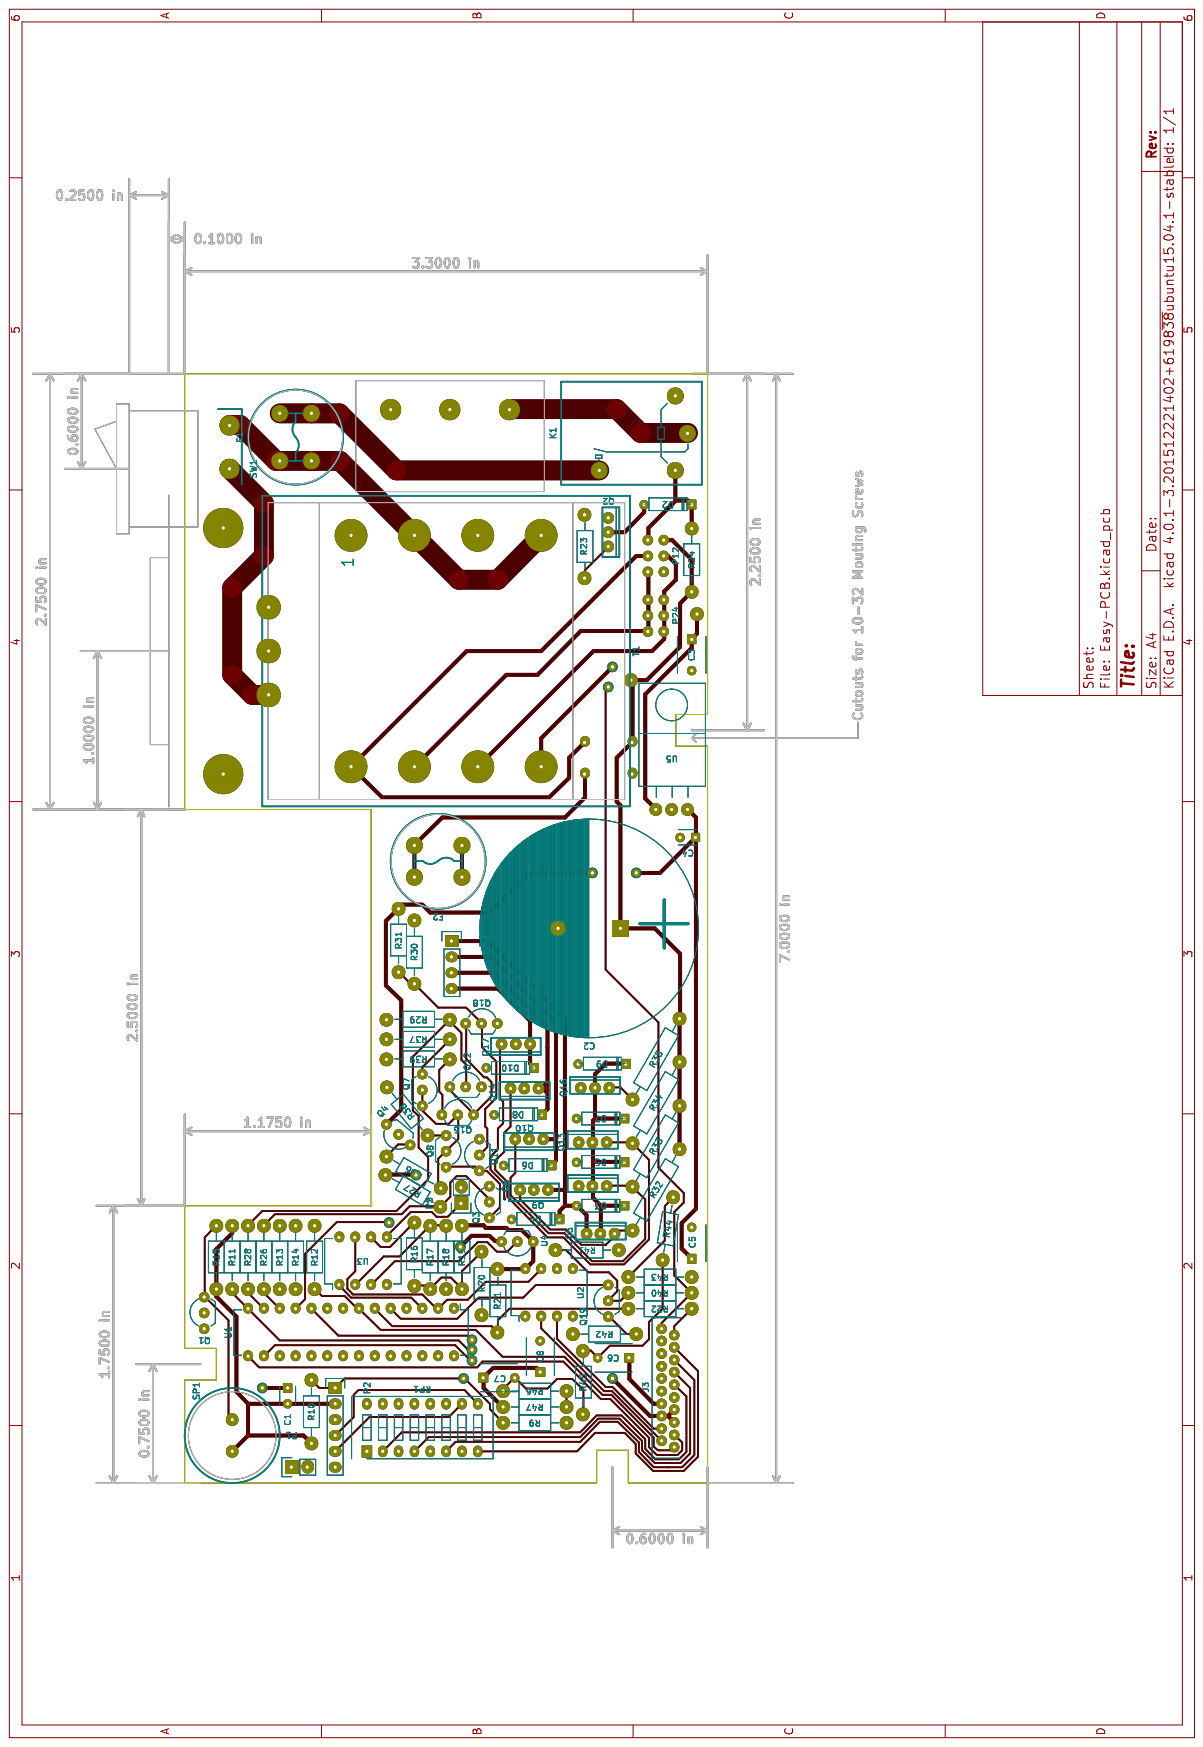
[picture p36: page 1]
