benlorenzetti/Breadboard-Oven/Drawings/Front-PCB-Drawing.pdf

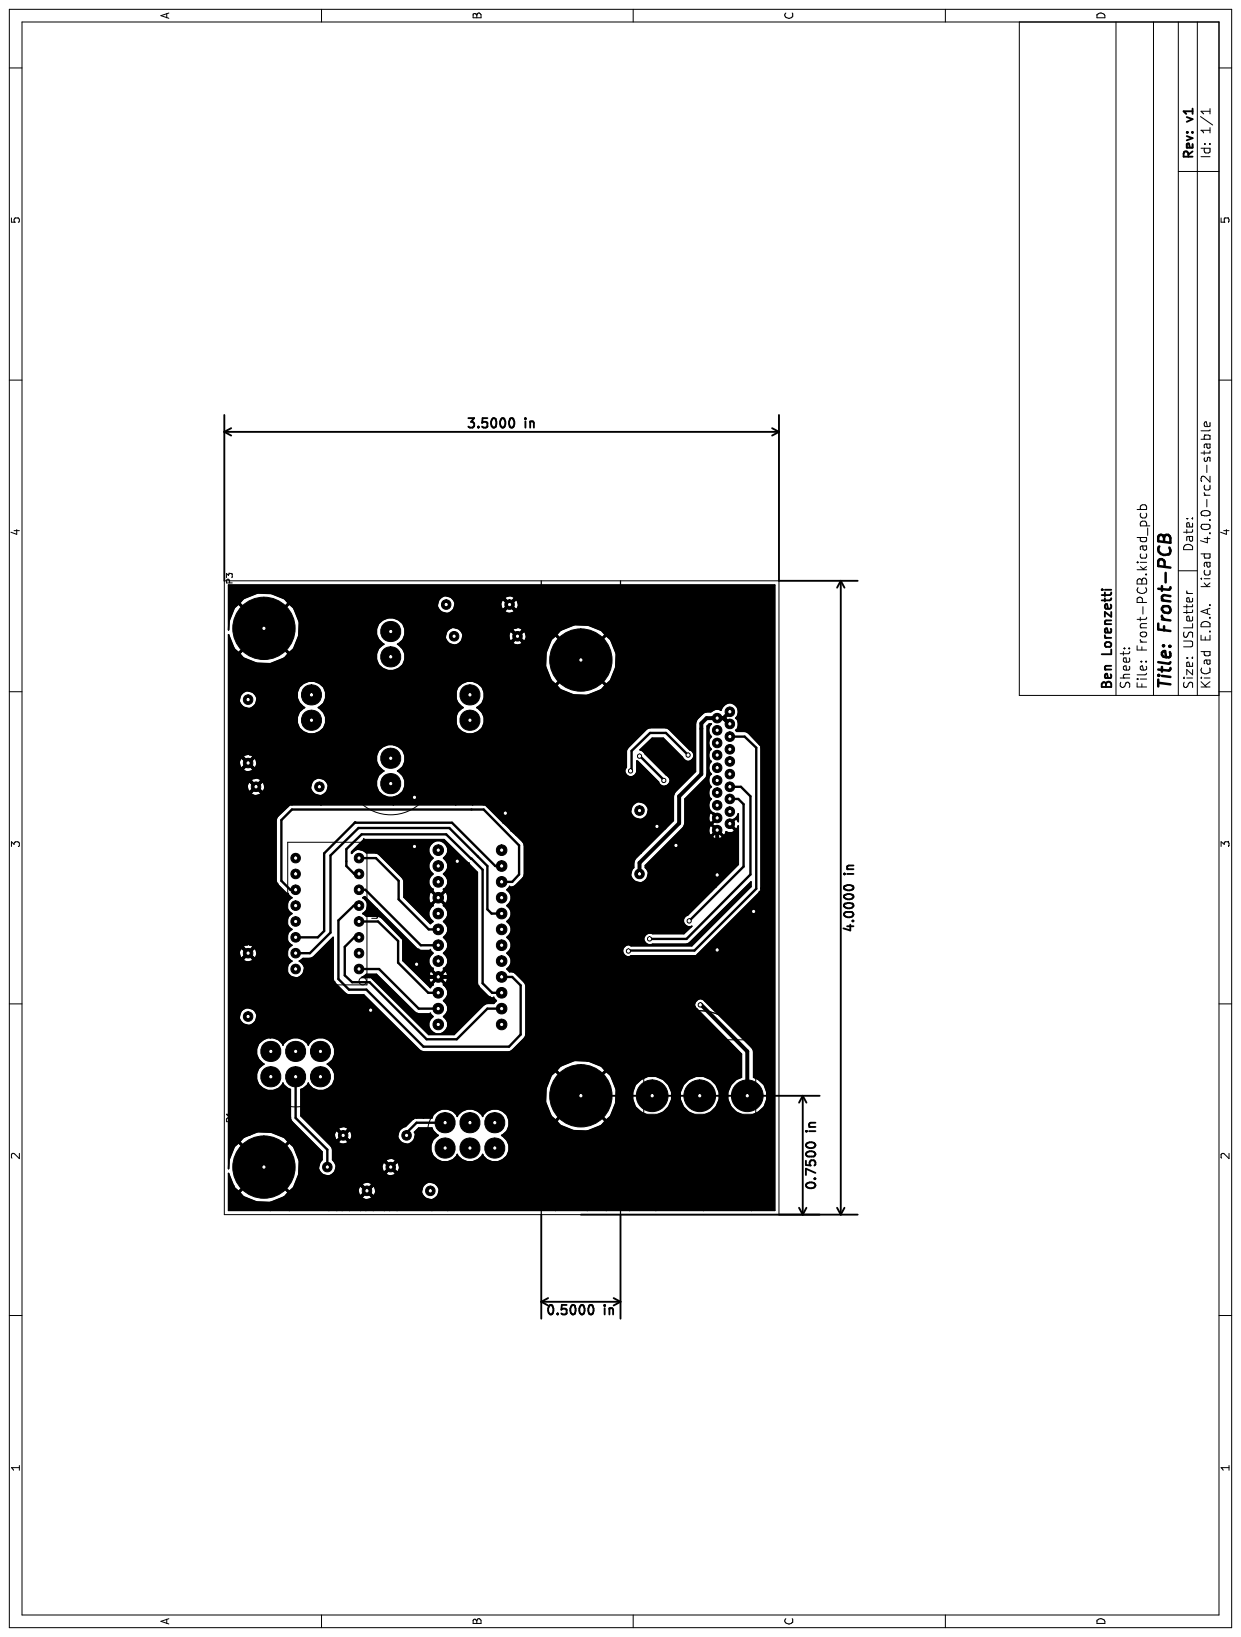
[picture p37: page 1]
