benlorenzetti/Breadboard-Oven/KiCad/Easy-PCB.kicad_pcb

## KiCad design KiCad/Easy-PCB.kicad_pcb (2016-02-04)

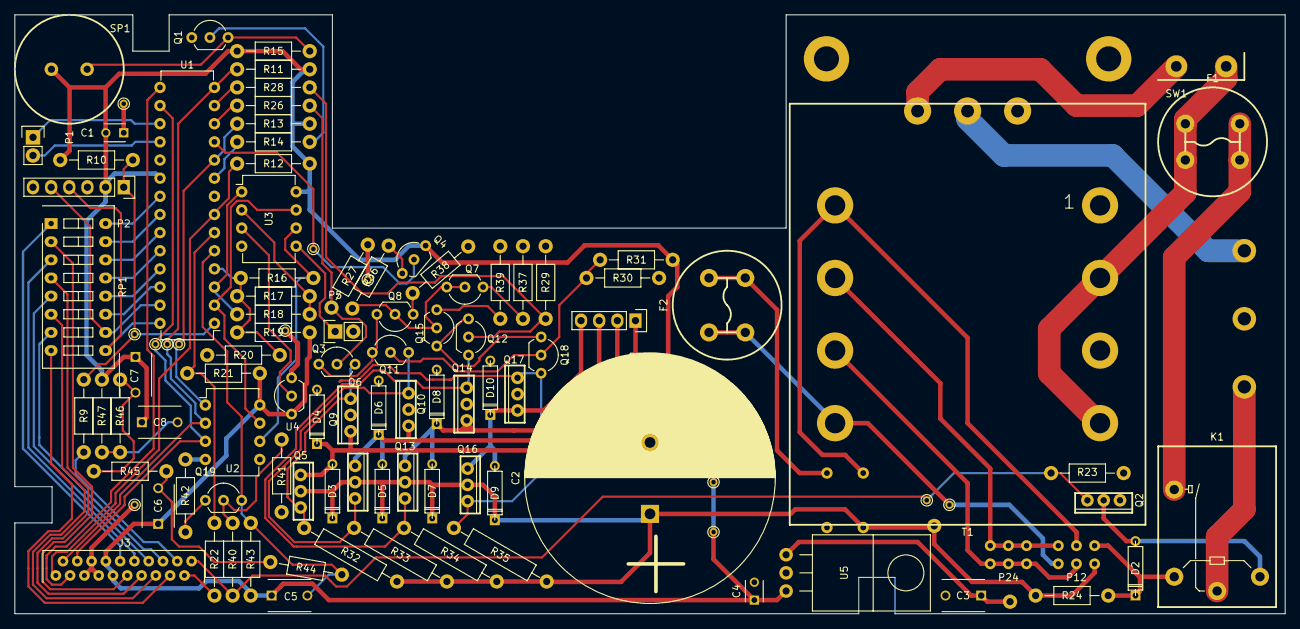
[picture p38: board Easy-PCB.kicad_pcb from above]

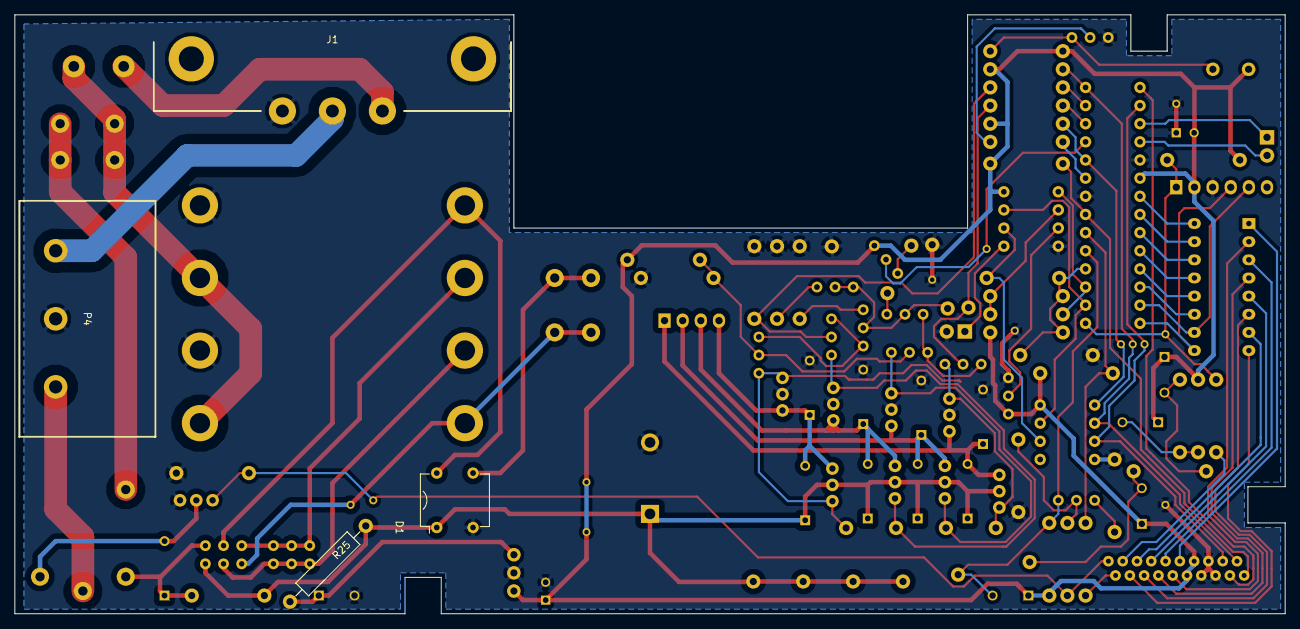
[picture p39: board Easy-PCB.kicad_pcb from below]

Board: 2 copper layers, 177.8 x 83.8 mm, 111 parts (4 on the bottom side), 81 nets.

Parts:
C1: 0.1u; C_Disc_D3_P2.5
C2: >16.6 mF; C_Radial_D35_L51_P10
C3: 0.33 uF; C_Disc_D6_P5
C4: 0.1 uF; C_Disc_D3_P2.5
C5, C6, C7, C8: CP1; C_Disc_D6_P5
D1: DF04M
D2: V*A(max) > 0.4 W; D3
D3, D4, D5, D6, D7, D8, D9, D10: D; D3
F1, F2: 83100000005; 83100000005_Fuse_Holder
J1: 703W-00/53; 703W-0053
J3: HLW20R-2C7LF
K1: G5LE-1A-E_DC12
P1, P5: 1x02; Socket_Strip_Straight_1x02
P2: 1x06; Socket_Strip_Straight_1x06
P3: 1x04; Socket_Strip_Straight_1x04
P4: 1x03 Terminal Block; 5-1437652-4
P6, P7, P8, P9, P10, P11, P13, P14, P15, P16, P17, P18, P19: via; PINTST
P12, P24: M20-9980346; Male_Header_2x03
P22: Screw Mounting; 10-32
Q1, Q3, Q4, Q7, Q8, Q11, Q12, Q15, Q18, Q19: 2N3904; TO-92
Q2, Q5, Q9, Q13, Q16: MJE340; MJE3x0
Q6, Q10, Q14, Q17: MJE350; MJE3x0
R9, R14, R15, R17, R20, R22: 1k; Resistor_Horizontal_RM10mm
R10, R11, R12, R13, R21: 10k; Resistor_Horizontal_RM10mm
R16: 100; Resistor_Horizontal_RM10mm
R18: 1.7k; Resistor_Horizontal_RM10mm
R19: 6.1k; Resistor_Horizontal_RM10mm
R23: 333; Resistor_Horizontal_RM10mm
R24: 330; Resistor_Horizontal_RM10mm
R25: 10 Ohm; >= 2W; Resistor_Horizontal_RM15mm
R26, R28: 140; Resistor_Horizontal_RM10mm
R27, R29: 115; Resistor_Horizontal_RM10mm
R30, R31: 64; Resistor_Horizontal_RM10mm
R32, R33, R34, R35: 165; Resistor_Horizontal_RM15mm
R36: 51; Resistor_Horizontal_RM10mm
R37, R38, R39: 10; Resistor_Horizontal_RM10mm
R40, R41, R42, R43, R44, R45, R46, R47: R; Resistor_Horizontal_RM10mm
RP1: 320; SW_DIP_x8_Slide
SP1: 2kHz Piezo; PS1420
SW1: R1966ABLKBLKFR
T1: VPP24-830
U1: PIC16F883; DIP-28
U2: MCP41050; DIP-8
U3: MCP617; DIP-8
U4: MCP9700A; TO-92
U5: LM7805; TO-220

Connections:
12Vrelay1: D2.1, K1.2, P12.6, R24.2
12Vrelay2: D2.2, K1.5, Q2.2
12or24VAC1: F2.1, F2.2, P8.1, P12.1, T1.12
12or24VAC2: D1.4, P12.4, T1.7
12or24VAC3: P12.3, P24.1, P24.3, P24.5, T1.10
12or24VAC4: P12.2, P24.2, P24.4, P24.6, T1.9
12or24VAC5: D1.3, F2.3, F2.4
/Analog Math/NichromeTemp: C5.2, Q19.3, R43.2, R44.2, U1.5
/Heat Relay/DoorC1: J3.19, R22.1
/Heat Relay/Heat: R21.2, R22.2, U1.6
/Heat Relay/HeatLive: K1.1, P4.1
/Motor Driver/wind1: R26.2, U1.12
/Motor Driver/wind1a: D3.2, D4.1, P3.1, Q5.1, Q6.1
/Motor Driver/wind1b: D5.2, D6.1, P3.2, Q9.1, Q10.1
/Motor Driver/wind2: R28.2, U1.13
/Motor Driver/wind2a: D7.2, D8.1, P3.3, Q13.1, Q14.1
/Motor Driver/wind2b: D9.2, D10.1, P3.4, Q16.1, Q17.1
/Power Circuit/MainsLive: F1.1, F1.2, SW1.2, T1.3, T1.6
/Temperature Feedback/K+: P5.1, U3.5
/Temperature Feedback/Tk: U1.2, U2.7, U3.7
/Temperature Feedback/Tref: R18.2, U1.3, U3.1
/Temperature Feedback/Vref-: R16.1, R17.1, R19.2, R20.1, U1.4
CS1: J3.1, R12.2, U1.7
CS2: P13.1, R13.2, U1.10, U2.1
DoorC2: J3.20, P9.1, Q2.3, R23.1, R40.2
Earth: J1.2, P4.3
GND: C1.1, C2.2, C3.2, C4.2, D1.2, D4.2, D6.2, D8.2, D10.2, J1.3, J3.5, J3.6, J3.7, P2.3, P4.2, P5.2, P14.1, P15.1, P17.1, P18.1, Q1.1, Q2.1, Q6.2, Q10.2, Q14.2, Q17.2, R20.2, R23.2, R27.2, R29.1, R31.2, R37.2, R38.2, R39.2, R41.2, R42.2, T1.1, T1.4, U1.8, U1.19, U2.4, U3.4, U4.3, U5.2
MISO: J3.3, U1.15
MOSI: J3.4, P10.1, U1.16, U2.3
Motor_On: P16.1, Q4.2, U1.11
unnamed: C6.2, R44.1, R45.2
unnamed: C7.2, R45.1, R46.2
unnamed: C8.2, R46.1, R47.2
unnamed: J1.1, SW1.1
unnamed: J3.10, RP1.1
unnamed: J3.11, RP1.2
unnamed: J3.12, RP1.3
unnamed: J3.13, RP1.4
unnamed: J3.14, RP1.5
unnamed: J3.15, RP1.6
unnamed: J3.16, RP1.7
unnamed: J3.17, RP1.8
unnamed: J3.18, R9.2
unnamed: P2.4, RP1.9, U1.28
unnamed: P2.5, RP1.10, U1.27
unnamed: Q1.2, R14.1
unnamed: Q1.3, R15.2, SP1.2
unnamed: Q3.2, R26.1, R27.1
unnamed: Q3.3, Q5.3, Q6.3, R32.2
unnamed: Q4.1, R36.2
unnamed: Q7.1, R37.1
unnamed: Q8.1, R38.1
unnamed: Q9.3, Q10.3, Q11.3, R33.2
unnamed: Q3.1, Q8.3, Q11.1
unnamed: Q11.2, Q18.2, R30.2, R31.1
unnamed: Q12.1, Q15.3, Q18.1
unnamed: Q12.2, R28.1, R29.2
unnamed: Q12.3, Q13.3, Q14.3, R34.2
unnamed: Q15.1, R39.1
unnamed: Q7.2, Q7.3, Q8.2, Q15.2, R36.1
unnamed: Q16.3, Q17.3, Q18.3, R35.2
unnamed: Q19.1, R42.1
unnamed: Q19.2, R40.1, R41.1
unnamed: R14.2, U1.9
unnamed: R16.2, U2.6, U3.6
unnamed: R17.2, R18.1, U3.2
unnamed: RP1.11, U1.26
unnamed: RP1.12, U1.25
unnamed: RP1.13, U1.24
unnamed: RP1.14, U1.23
unnamed: RP1.15, U1.22
unnamed: RP1.16, U1.21
unnamed: U3.3, U4.2
RX: P1.2, U1.18
Reset: P2.1, P19.1, R9.1, R10.2, U1.1
SCK: J3.2, P11.1, R11.2, U1.14, U2.2
TX: P1.1, U1.17
VAA: F1.3, F1.4, K1.3
VCC: C2.1, D1.1, D3.1, D5.1, D7.1, D9.1, P12.5, Q5.2, Q9.2, Q13.2, Q16.2, R24.1, R25.2, R32.1, R33.1, R34.1, R35.1
VDD: C1.2, C4.1, C5.1, C6.1, C7.1, C8.1, J3.8, J3.9, P2.2, P6.1, P7.1, Q4.3, R10.1, R11.1, R12.1, R13.1, R15.1, R19.1, R21.1, R30.1, R43.1, R47.1, SP1.1, U1.20, U2.8, U3.8, U4.1, U5.3
VDDunreg: C3.1, R25.1, U5.1
