benlorenzetti/Breadboard-Oven/KiCad/Front-PCB.kicad_pcb

## KiCad design KiCad/Front-PCB.kicad_pcb (2015-11-28)

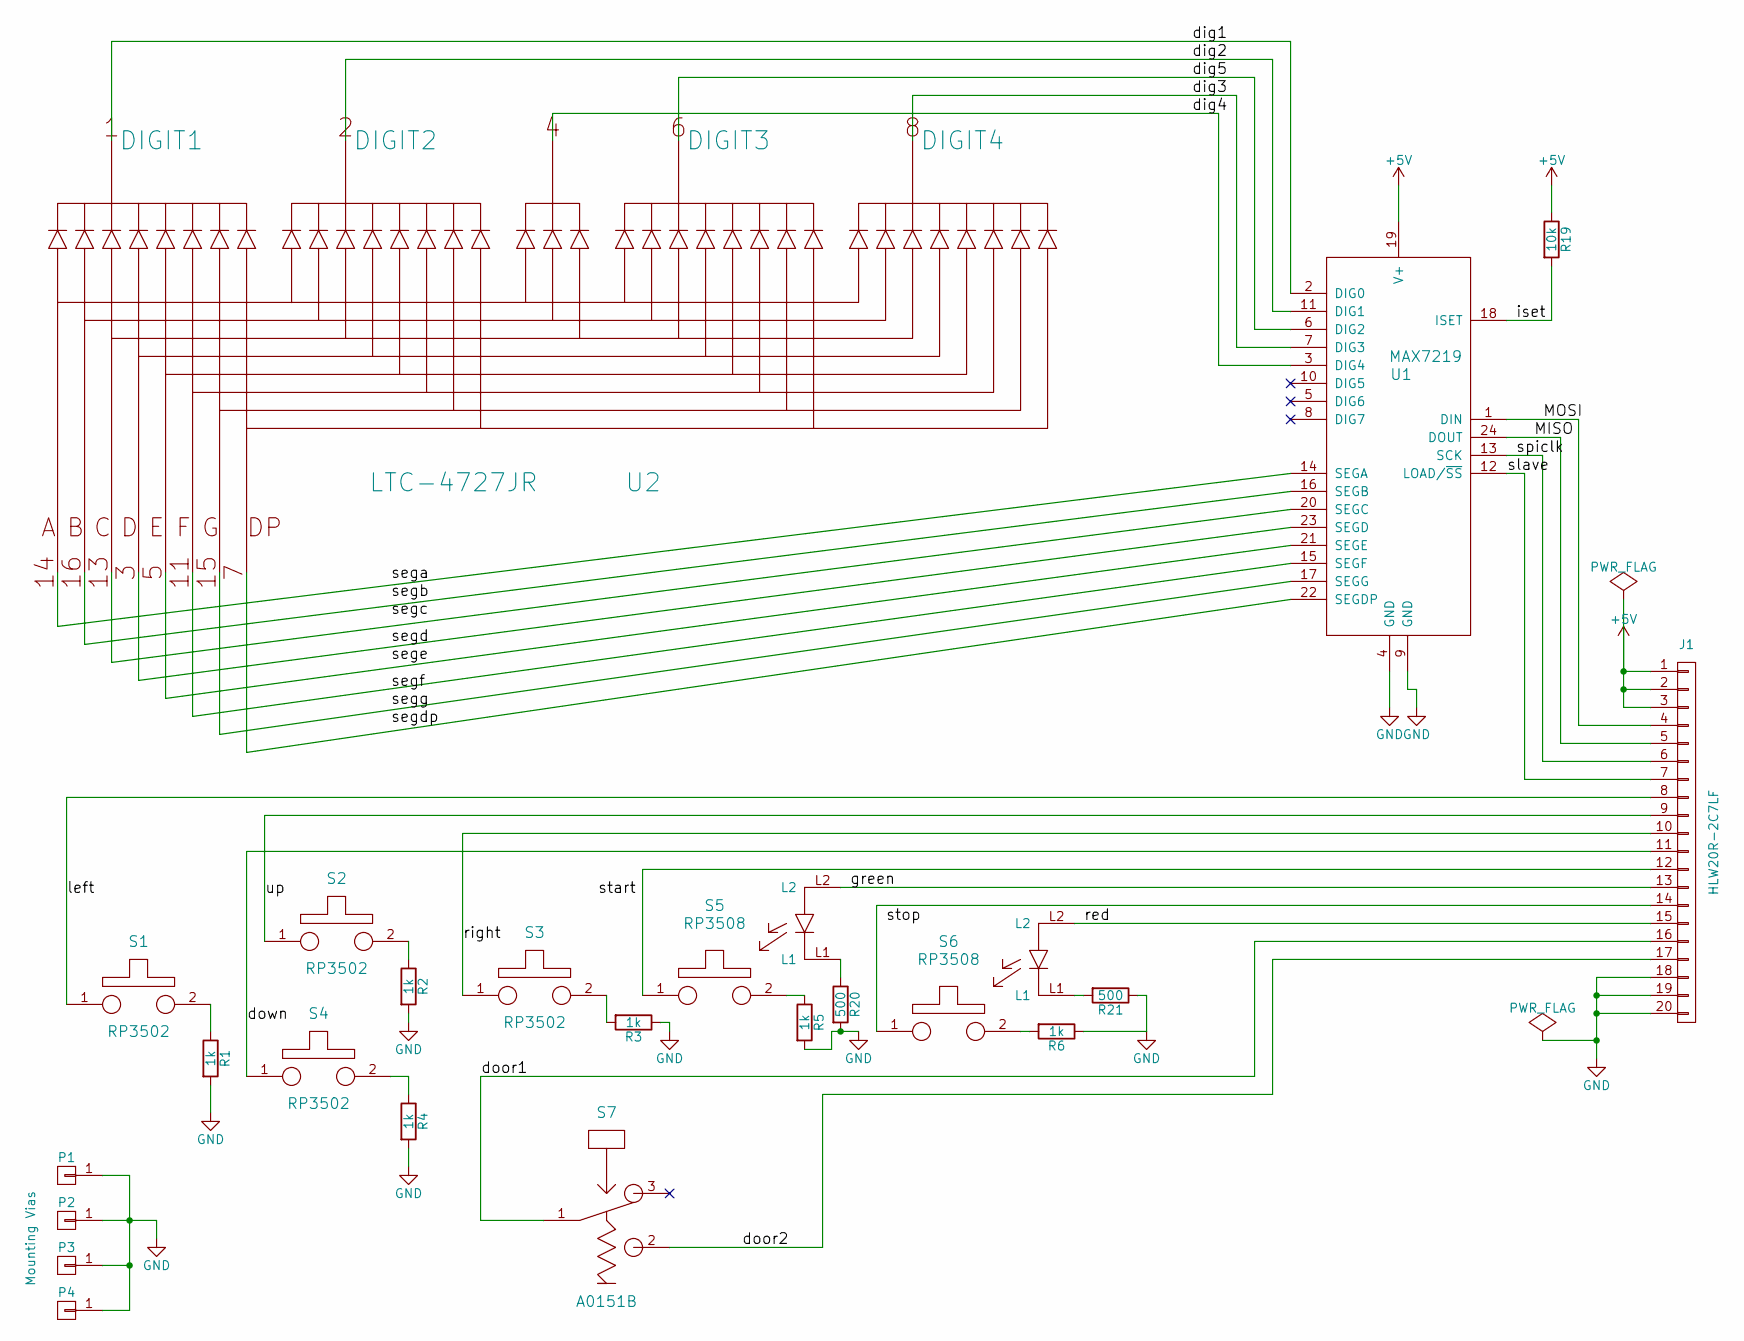
[picture p40: schematic Front-PCB.sch, Front Facing PCB]

Parts:
J1: HLW20R-2C7LF
P1: Mounting Vias; 10-32
P2, P3, P4: CONN_01X01; 10-32
R1, R2, R3, R4, R5, R6: 1k; R4
R19: 10k; R4
R20, R21: 500; R4
S1, S2, S3, S4: RP3502
S5, S6: RP3508
S7: A0151B
U1: MAX7219; 4824-3000-CP
U2: LTC-4727JR

Connections:
+5V: J1.1, J1.2, J1.3, R19.1, U1.19 (V+)
/MISO: J1.5, U1.24 (DOUT)
/MOSI: J1.4, U1.1 (DIN)
/dig1: U1.2 (DIG0), U2.1 (DIGIT1)
/dig2: U1.11 (DIG1), U2.2 (DIGIT2)
/dig3: U1.7 (DIG3), U2.8 (DIGIT4)
/dig4: U1.3 (DIG4), U2.4
/dig5: U1.6 (DIG2), U2.6 (DIGIT3)
/door1: J1.16, S7.1
/door2: J1.17, S7.2
/down: J1.11, S4.1
/green: J1.13, S5.L2
/iset: R19.2, U1.18 (ISET)
/left: J1.8, S1.1
/red: J1.15, S6.L2
/right: J1.10, S3.1
/slave: J1.7, U1.12 (LOAD/~SS)
/spiclk: J1.6, U1.13 (SCK)
/up: J1.9, S2.1
GND: J1.18, J1.19, J1.20, P1.1, P2.1, P3.1, P4.1, R1.2, R2.2, R3.1, R4.2, R5.2, R6.1, R20.2, R21.1, U1.4 (GND), U1.9 (GND)
unnamed: J1.12, S5.1
unnamed: J1.14, S6.1
unnamed: R1.1, S1.2
unnamed: R2.1, S2.2
unnamed: R3.2, S3.2
unnamed: R4.1, S4.2
unnamed: R5.1, S5.2
unnamed: R6.2, S6.2
unnamed: R20.1, S5.L1
unnamed: R21.2, S6.L1
unnamed: U1.14 (SEGA), U2.14
unnamed: U1.15 (SEGF), U2.11
unnamed: U1.16 (SEGB), U2.16
unnamed: U1.17 (SEGG), U2.15
unnamed: U1.20 (SEGC), U2.13
unnamed: U1.21 (SEGE), U2.5
unnamed: U1.22 (SEGDP), U2.7
unnamed: U1.23 (SEGD), U2.3

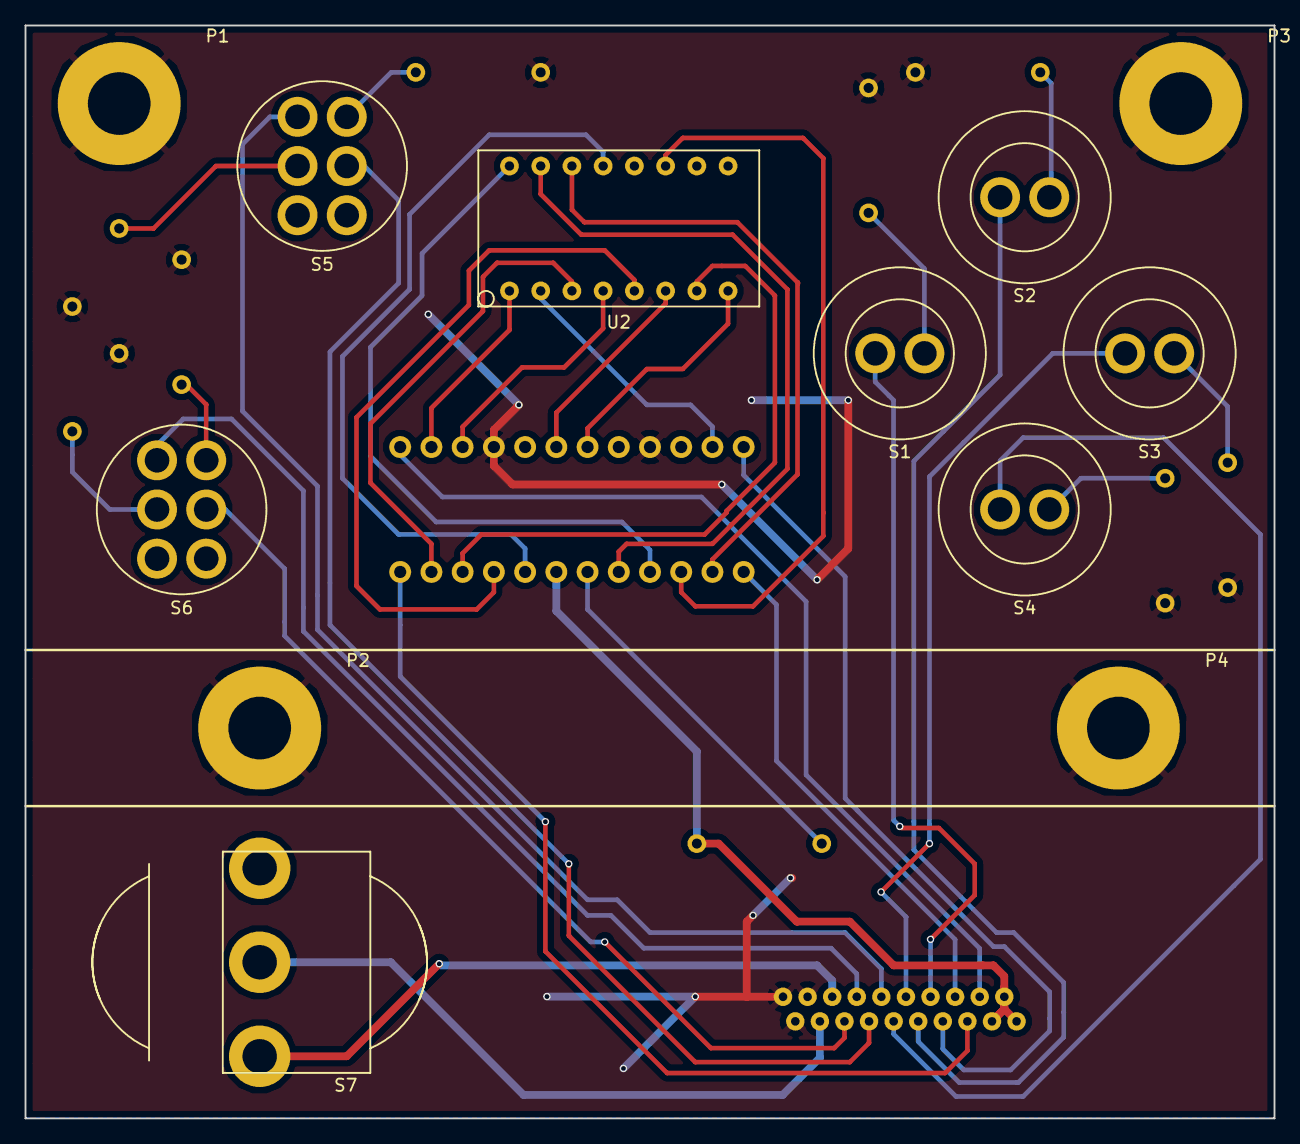
[picture p41: board Front-PCB.kicad_pcb from above]

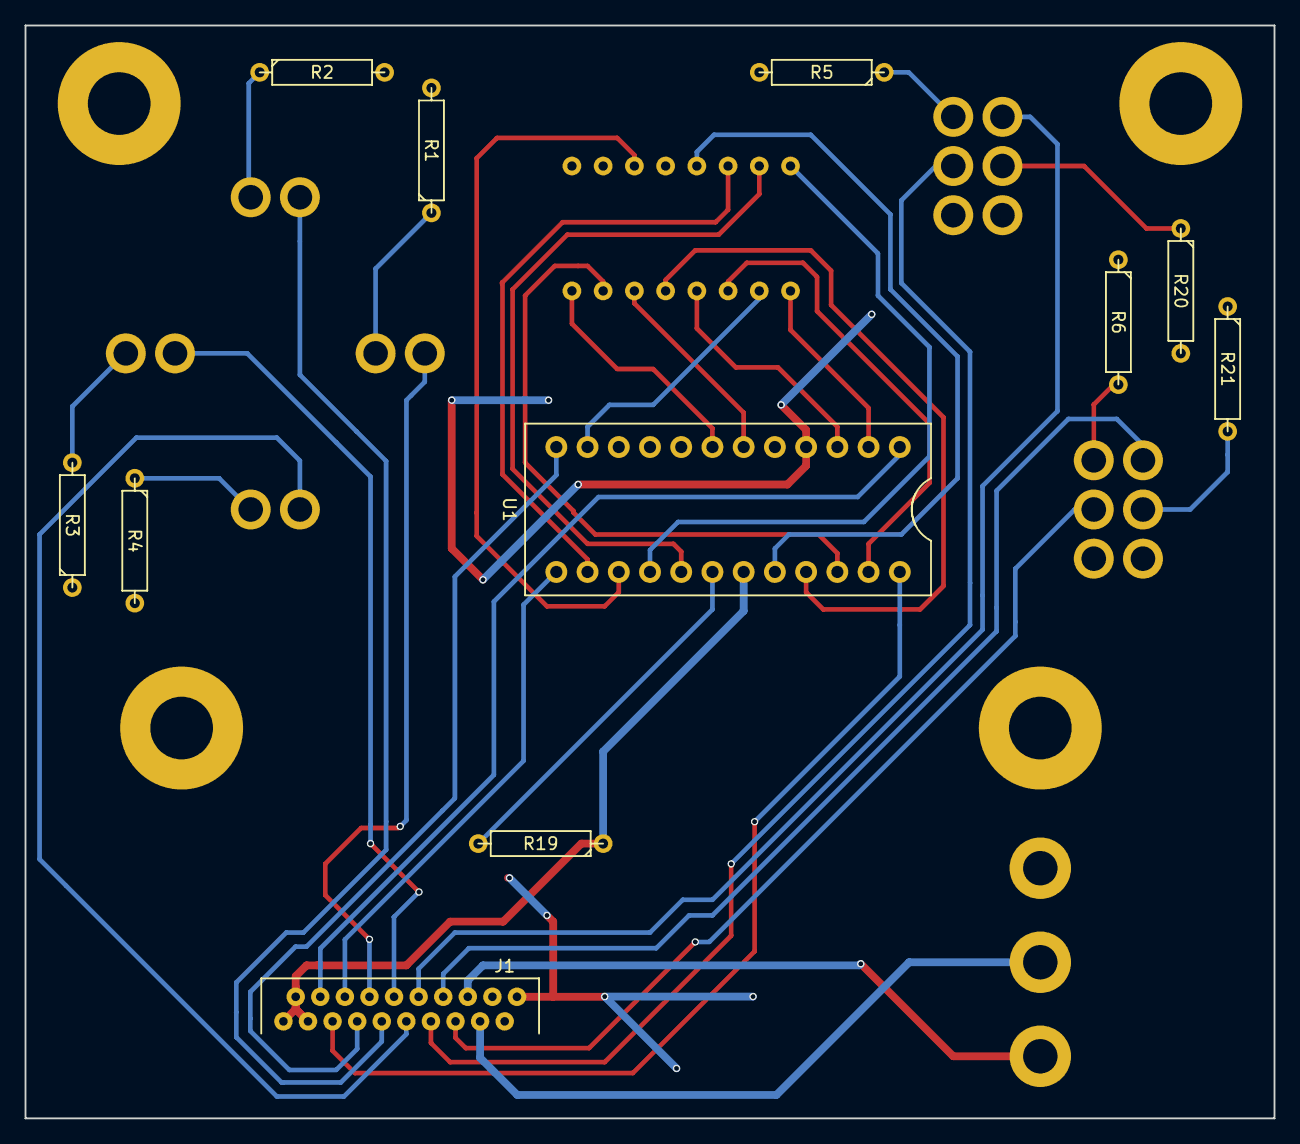
[picture p42: board Front-PCB.kicad_pcb from below]

Board: 2 copper layers, 101.6 x 88.9 mm, 23 parts (11 on the bottom side), 38 nets.
