benlorenzetti/Breadboard-Oven/PIC-Program/easy-pcb.asm

#include <p16f883.inc>
	__CONFIG	_CONFIG1, _LVP_OFF & _FCMEN_OFF & _IESO_OFF & _BOR_OFF & _CPD_OFF & _CP_OFF & _MCLRE_OFF & _PWRTE_ON & _WDT_OFF & _INTRC_OSC_NOCLKOUT
	__CONFIG	_CONFIG2, _WRT_OFF & _BOR21V

#define	SS	RA5
#define	SCK	RC3
#define	SDI	RC4
#define SDO	RC5
#define	LEFT	RB4
#define UP	RB1
#define	DOWN	RB5
#define	RIGHT	RB7
#define	START	RB6
#define	STOP	RB0
#define	GRN_LED	RB3
#define	RED_LED	RB3
#define	ALARM	RA4
#define	HEAT	RA3
#define	T_REF	RA0
#define	A_REF	0	; The analog input channel corresponding to pin T_REF
#define	T_K	RA1
#define	A_K	1	; The analog input channel corresponding to pin T_K
#define	V_REF_MINUS	RA2	; the negative reference voltage for Kn-
#define	A_REF_MINUS	2	; the analog input channel corresponding to Vref-
#define	MOTOR_ON	RC0
#define	WINDING1	RC2
#define	WINDING2	RC1

#define	STATIC_VARIABLES	0x20
#define	MAX_ARRAY_SIZE	.8	; 96 bytes are available in banks 2 and 3
#define	TIME_ARRAY	0x110
#define	TEMP_ARRAY	0x190

#define	UINT16_T	2

#define	TT_BOOLEAN	0
#define	START_BOOLEAN	1

#define	FOSK_SELECT		B'111'	; 111 for Fosc = 8 MHz
#define	ADC_CLOCK_SELECT	B'10'	; 10 for Fosc/32
#define	TIMER0_PRESCALAR	B'110'	; 110 for 1:128, or Fosc/(4 * 128)
#define	HALF_BRIDGE_PERIOD	.100


#define	TMR0_PERIOD	.125	; 125 selected for 2kHz piezo
#define	TIME_COUNTER_SET_VALUE	.25
#define	LED_INTENSITY	.8	; Light Intensity from 0-15

; Digits 0-9 have lookup indices 0-9, but :, deg, and C
#define	SEMICOLON	.10	
#define	DEGREE_SIGN	.11
#define	CELSIUS	.12
#define	ALL_OFF	.13

	cblock	0x20
		t0
		T0
		t1
		T1
		t2
		T2
		t3
		T3
		t4
		T4
		t5
		T5
		t6
		T6
		t7
		T7
		data_index
		time: UINT16_T
		Temp
		booleans_reg
		time_counter_L
		time_counter_H
		datapoint
		POSITION_RAM
		POSITION_EE
		LastTime
		SPI_tx1	; first byte to be transfered out by SPI
		SPI_tx2	; second byte to be transfered out by SPI
		; LED Display Function Variables
		seconds: UINT16_T
		minutes
		dig1
		dig2
		dig3
		dig4
		digSpecial
		delay1
		delay2
		delay3
		temp
	endc

	ORG 	0x0
Reset_Vector
	GOTO	Initialize_IO

Interupt_Vector
	ORG	0x4
	BANKSEL	0
	CLRF	PORTA	; shut down all potential output signals
	CLRF	PORTB	; (i.e. shut down the relay)
	CLRF	PORTC
	BCF	booleans_reg, START_BOOLEAN
	BTFSC	PORTB, START
	BSF	booleans_reg, START_BOOLEAN
	GOTO	Initialize_IO	; reinitialize program state/memory

;________________________Function Definitions_______________________;

; W LED_lookup_table (W); // warning: undefined behavior if W > 13
	ORG	0x10
LED_Lookup_Table
	; MUST MAKE SURE THE TABLE WILL NOT CROSS A 256 BYTE BOUNDARY!
	ADDWF	PCL, F
	RETLW	B'01111110'	; 0
	RETLW	B'00110000'	; 1
	RETLW	B'01101101'	; 2
	RETLW	B'01111001'	; 3
	RETLW	B'00110011'	; 4
	RETLW	B'01011011'	; 5
	RETLW	B'01011111'	; 6
	RETLW	B'01110000'	; 7
	RETLW	B'01111111'	; 8
	RETLW	B'01110011'	; 9
	RETLW	B'01100000'	; semicolon for clock
	RETLW	B'00010000'	; degree sign for temperature
	RETLW	B'01001110'	; C for celsius
	RETLW	B'00000000'	; All off

; void CLRF_X (uintX_t *addr);
CLRF_X	MACRO	Addr, Addr_Size
	local	i = 0
	while	i < Addr_Size
	  CLRF	(Addr + i)
	i = i + 1
	endw
	ENDM

; void COPY_X (uintX_t *source, uintX_t *destination);
COPY_X	MACRO	src, dest, size
	local	i = 0
	while	i < size
	  MOVF	(src + i), W
	  MOVWF	(dest + i)
	  i = i + 1
	endw
	ENDM

; void SUBWF_X (uintX_t *addr, uint8_t W);
SUBWF_X	MACRO	Addr, Addr_Size
	; Declare a unique "break" label for each instantiation of SUBWF_X
	; and a local variable for expanding Addr_Size times
	local	Break, i
	variable	i = 0
	while	i < Addr_Size
	  SUBWF	(Addr + i), F
	  BTFSC	STATUS, C
	  GOTO	Break
	  MOVLW	1
	  i = i + 1	
	endw
Break
	ENDM

; void Update_LED_Display (uint16_t time, uint8_t Temp, uint8_t *tT_boolean);
Update_LED_Display
	CLRF	dig1
	CLRF	dig2
	CLRF	dig3
	CLRF	dig4	
	BANKSEL	STATIC_VARIABLES
	BTFSC	booleans_reg, TT_BOOLEAN
	GOTO	Binary_to_Decimal_for_Temp
Seconds_to_Minutes_for_Time
	CLRF	minutes
	COPY_X	time, seconds, UINT16_T
Divide_by_60_Loop
	MOVLW	.60
	SUBWF_X	seconds, UINT16_T
	BTFSC	STATUS, C
	INCF	minutes, F
	BTFSC	STATUS, C
	GOTO	Divide_by_60_Loop
	MOVLW	.60
	ADDWF	seconds, F
Binary_to_Decimal_for_Seconds
	MOVLW	.10
	SUBWF	seconds, F
	BTFSC	STATUS, C
	INCF	dig2, F
	BTFSC	STATUS, C
	GOTO	Binary_to_Decimal_for_Seconds
	MOVLW	.10
	ADDWF	seconds, F
Binary_to_Decimal_for_Minutes
	MOVLW	.10
	SUBWF	minutes, F
	BTFSC	STATUS, C
	INCF	dig4, F
	BTFSC	STATUS, C
	GOTO	Binary_to_Decimal_for_Minutes
	MOVLW	.10
	ADDWF	minutes, F
Prepare_to_Display_Time
	MOVF	seconds, W
	MOVWF	dig1
	MOVF	minutes, W
	MOVWF	dig3
	MOVLW	SEMICOLON
	MOVWF	digSpecial
	GOTO	Update_5_Digits
Binary_to_Decimal_for_Temp
	MOVF	Temp, W
	MOVWF	dig2
	MOVLW	.2
	MOVWF	dig3	; add 20, because Temp=0 represents T=20deg
Subtract_Division_Loop
	MOVLW	.10		
	SUBWF	dig2, F	; subtract 10 from dividend
	BTFSS	STATUS, C	; did an underflow occur?
	GOTO	Remainder_Restoration	; if so, then division loop is complete
	INCF	dig3, F	; increment 10s digit
	BTFSS	dig3, 3	; test if 10s has carry over (test 8 digit)
	GOTO	Subtract_Division_Loop
	BTFSS	dig3, 1	; (test 2 digit; 8+2 = 10)
	GOTO	Subtract_Division_Loop
	MOVLW	.10
	SUBWF	dig3, F	; subtract 10 from the 10s digit
	INCF	dig4, F	; increment the 100s digit from 10s carry over
	GOTO	Subtract_Division_Loop
Remainder_Restoration
	MOVLW	.10
	ADDWF	dig2, F
Prepare_to_Display_Temp
	MOVLW	DEGREE_SIGN
	MOVWF	digSpecial
	MOVLW	CELSIUS
	MOVWF	dig1
Update_5_Digits
	MOVLW	0x5	; MAX7219 digit 0 address for degree sign
	MOVWF	SPI_tx1
	MOVF	digSpecial, W
	CALL	LED_Lookup_Table	; lookup A-DP code for semicolon
	MOVWF	SPI_tx2
	CALL	SPI_2byte_Transfer
	MOVLW	0x1	; MAX7219 digit 1 address for leftmost display digit
	MOVWF	SPI_tx1
	MOVF	dig4, W
	CALL	LED_Lookup_Table	; lookup appropriate A-DP code
	MOVWF	SPI_tx2
	CALL	SPI_2byte_Transfer
	MOVLW	0x2	; MAX7219 digit 2 address for 2nd to left digit
	MOVWF	SPI_tx1
	MOVF	dig3, W
	CALL	LED_Lookup_Table	; lookup appropriate A-DP code
	MOVWF	SPI_tx2
	CALL	SPI_2byte_Transfer	; send data through SPI
	MOVLW	0x3	; MAX7219 digit 3 address for 3rd to left digit
	MOVWF	SPI_tx1
	MOVF	dig2, W
	CALL	LED_Lookup_Table	; lookup appropriate A-DP code
	MOVWF	SPI_tx2
	CALL	SPI_2byte_Transfer	; send data through SPI
	MOVLW	0x4	; MAX7219 digit 4 address for rightmost display digit
	MOVWF	SPI_tx1
	MOVF	dig1, W
	CALL	LED_Lookup_Table	; lookup appropriate A-DP code
	MOVWF	SPI_tx2
	CALL	SPI_2byte_Transfer	; send data through SPI

	RETURN

; Loads time and temperature datapoints into time_L and Temp variables
Compatibility_Function
	BANKSEL	STATIC_VARIABLES
	MOVF	datapoint, W	; get address of value to be displayed
	MOVWF	FSR		; get value
	MOVF	INDF, W		; store value in W	
	MOVWF	temp
	BTFSS	datapoint, 0	; test if datapoint is a time or Temp
	MOVWF	time		; if time, store in time_L
	BTFSC	datapoint, 0
	MOVWF	Temp		; if Temp, store in Temp
	BCF	booleans_reg, TT_BOOLEAN
	BTFSC	datapoint, 0
	BSF	booleans_reg, TT_BOOLEAN
	RETURN
 
Waste_Time	MACRO	s1, s2, s3
    	MOVLW	s1
	MOVWF	delay1
	MOVLW	s2
	MOVWF	delay2
	MOVLW	s3
	MOVWF	delay3
	DECFSZ	delay1, F
	GOTO	$-1
	DECFSZ	delay2, F
	GOTO	$-3
	DECFSZ	delay3, F
	GOTO	$-5
	ENDM

; void spi_2byte_transfer (SPI_tx1, SPI_tx2);
SPI_2byte_Transfer
	BANKSEL	0x0
	BCF	PORTA, SS	; pull MAX7219 slave select active low
	MOVF	SPI_tx1, W	; get the first byte to transmit
	MOVWF	SSPBUF		; start transmission
	BANKSEL	SSPSTAT
	BTFSS	SSPSTAT, BF	; has data been received (transmit complete?)
	GOTO	$-1
	BANKSEL	STATIC_VARIABLES
	MOVF	SPI_tx2, W
	BANKSEL	SSPBUF
	MOVWF	SSPBUF		; start transmission
	BANKSEL	SSPSTAT
	BTFSS	SSPSTAT, BF	; wait for transmission completion
	GOTO	$-1
	BANKSEL	0x0		; return to bank 0...
	BSF	PORTA, SS	; rising edge on MAX7219 LOAD/SS line
	Waste_Time	.16, .1, .1
	RETURN

Initialize_MAX7219
	; Leave Sleep Mode
	MOVLW	0xC		; MAX7219 shutdown address
	MOVWF	SPI_tx1
	MOVLW	0x1		; xxxx xxx1 for normal operation (xxxx xxx0 for shutdown)
	MOVWF	SPI_tx2
	CALL	SPI_2byte_Transfer
	; Leave Sleep Mode
	MOVLW	0xF		; MAX7219 display test address
	MOVWF	SPI_tx1
	MOVLW	0x0		; xxxx xxx0 for normal operation (xxxx xxx1 for test)
	MOVWF	SPI_tx2
	CALL	SPI_2byte_Transfer
	; Set scan limit to digits 0-4
	MOVLW	0xB		; MAX7219 scan limit address
	MOVWF	SPI_tx1
	MOVLW	0x4		; xxxx x100 for digits 0-4
	MOVWF	SPI_tx2
	CALL	SPI_2byte_Transfer
	; Set BCD Mode to No Decoding
	MOVLW	0x9		; MAX7219 shutdown address
	MOVWF	SPI_tx1
	MOVLW	0x0		; 0000 0000 for no decoding on any digit
	MOVWF	SPI_tx2
	CALL	SPI_2byte_Transfer
	; Set Intensity Level
	MOVLW	0xA		; MAX7219 intensity address
	MOVWF	SPI_tx1
	MOVLW	LED_INTENSITY	; the desired duty cycle, 0-15 are valid values
	MOVWF	SPI_tx2
	CALL	SPI_2byte_Transfer
	RETURN

; void Time_Counting_Loop (uint8_t *time_counter_L, uint8_t *time_counter_H);
Time_Counting_Loop
	BTFSS	INTCON, T0IF	; Test for Timer0 Overflow (note INTCON is in all banks)
	GOTO	$-1
	BCF	INTCON, T0IF
	BANKSEL	TMR0
	MOVLW	(.255 - TMR0_PERIOD)	; Reset TMR0
	MOVWF	TMR0
	; Toggle Alarm (note bank 0 for digital I/O and time_counter)
	BANKSEL	0x0
	MOVLW	(1 << ALARM)
	XORWF	PORTA, F
	; Test for Timer1 period (timer1 is driving the fan)
	BANKSEL	TMR1H
	MOVLW	HALF_BRIDGE_PERIOD
	SUBWF	TMR1H, W
	BTFSC	STATUS, C
	CLRF	TMR1H
	; Decrement (time_counter--) and for time_counter loops' completions
	BANKSEL	STATIC_VARIABLES
	DECFSZ	time_counter_L	; Decrement (time_counter--)
	GOTO	Time_Counting_Loop
	DECFSZ	time_counter_H
	GOTO	Time_Counting_Loop
	RETURN

;________________________Begin Main Program_________________________;

Initialize_IO
	BANKSEL	TRISA
	MOVLW	(0<<SS) | (1<<T_REF)| (1<<T_K) | (1<<V_REF_MINUS) | (1<<HEAT) | (1<<ALARM)
	MOVWF	TRISA
	MOVLW	(1<<STOP) | (1<<LEFT) | (1<<UP) | (1<<DOWN) | (1<<RIGHT) | (1<<START) | (0<<GRN_LED) | (0<<RED_LED)
	MOVWF	TRISB
	MOVLW	(0<<SCK) | (1<<SDI) | (0<<SDO) | (0<<MOTOR_ON) | (0<<WINDING1) | (0<<WINDING2)
	MOVWF	TRISC
	BANKSEL	WPUB
	MOVLW	(1<<LEFT) | (1<<RIGHT) | (1<<UP) | (1<<DOWN) | (1<<START) | (1<<STOP)
	MOVWF	WPUB	; enable weak pullups for pushbutton inputs
	BANKSEL	OPTION_REG
	BCF	OPTION_REG, NOT_RBPU	; enable global pullups
	BANKSEL	ANSEL
	MOVLW	(1<<A_REF) | (1<<A_K) | (1<<A_REF_MINUS)
	MOVWF	ANSEL
	BANKSEL	ANSELH
	CLRF	ANSELH

Blink_Red_Once
	BANKSEL	PORTB
	BSF	PORTB, RED_LED
	Waste_Time	.256, .256, .4
	BCF	PORTB, RED_LED
	Waste_Time	.256, .256, .4
 
Initialize_System_Clock
	BANKSEL	OSCCON
	MOVLW	(FOSK_SELECT << IRCF0) | (0 << OSTS) | (1 << SCS)
	; select the internal 8 MHz oscillator and set its prescalar
	MOVWF	OSCCON
	; A start-up timer is built into the hardware so no delay is needed

Initialize_ADC
	BANKSEL	ADCON1
	BCF	ADCON1, ADFM	; Left justify the result (upper 8 bits of result will be stored in ADRESH)
	BSF	ADCON1, VCFG1	; Set Vref- to Vss
	BCF	ADCON1, VCFG0	; Set Vref+ to Vdd
	BANKSEL	ADCON0
	MOVLW	(ADC_CLOCK_SELECT << ADCS0) & ((1 << ADCS0) | (1 << ADCS1))
	BCF	ADCON0, ADCS1	; Select Fosc/8 for ADC clock period because that is recommended for Fosc=4MHz
	BSF	ADCON0, ADCS0	; the code for this is 01 from datasheet page 108

Initialize_Data
	BANKSEL	STATIC_VARIABLES
	MOVLW	0x20
	MOVWF	datapoint
	MOVWF	POSITION_RAM
	CLRF	POSITION_EE
	CLRF_X	time, UINT16_T
	CLRF	Temp
	BCF	booleans_reg, TT_BOOLEAN

Initialize_Interupt_Sources
	BANKSEL	PORTB
	MOVLW	1 << RB0
	ANDWF	PORTB, W	; save portB so it can be used to determine the
	BANKSEL	OPTION_REG	;   default state of the RB0 interupt
	BCF	OPTION_REG, INTEDG	; interupt on falling edge of RB0/INT pin
	BTFSC	STATUS, Z	; unless RB0 is already fallen, then
	BSF	OPTION_REG, INTEDG	; interupt on rising edge.
	BCF	INTCON, INTF	; clear external RB0 interupt flag
	BSF	INTCON, INTE	; enable external RB0 interupt
	BCF	INTCON, RBIE	; disable port B change interupts
	BANKSEL	PIE1
	CLRF	PIE1		; disable a whole bunch of interupts
	BANKSEL	PIE2
	CLRF	PIE2		; disable a whole bunch of interupts
	BSF	INTCON, GIE	; set global interupt enable

Initialize_Timer1_CCP1_and_CCP2	; for motor
	BANKSEL	T1CON
	CLRF	T1CON	; sets T1CKPS<1:0> to '00' for prescalar 1:1
			; and sets TMR1CS to '0' for Fosc/4
	BSF	T1CON, TMR1ON	; enable timer 1
	
	BANKSEL	CCPR1L
	CLRF	CCPR1L
	MOVLW	(HALF_BRIDGE_PERIOD / 2)
	MOVWF	CCPR1H
	BANKSEL	CCPR2L
	CLRF	CCPR2L
	MOVLW	(HALF_BRIDGE_PERIOD - 1)
	MOVWF	CCPR2H

	BANKSEL	CCP1CON
	MOVLW	B'0010'	; enable CCP and set mode to Compare/toggle on match
	MOVWF	CCP1CON
	BANKSEL	CCP2CON
	MOVWF	CCP2CON


Initialize_SPI
	BANKSEL	SSPCON
	MOVLW	B'0001'	; set SSPM<3:0> for Master Mode, Fosc/4
	MOVWF	SSPCON
	BSF	SSPCON, CKP	; set clock idle state to high level
	BANKSEL	SSPSTAT
	BSF	SSPSTAT, SMP	; input data sampled at end of data output time
	BSF	SSPSTAT, CKE	; data transmitted on rising edge of clock (rising edge for MAX7219)
	BANKSEL	SSPCON
	BSF	SSPCON, SSPEN	; enable Serial Peripheral Interface

EE_READ:
	BANKSEL	STATIC_VARIABLES
    MOVF	POSITION_RAM,w
    MOVWF	FSR
    MOVF	POSITION_EE,w	    ;EEPROM ADDRESS
    BANKSEL	EEADR		    ;TO READ
    MOVWF	EEADR
    BANKSEL	EECON1
    BCF		EECON1,EEPGD	    ;POINT TO DATA MEMORY, NOT PROGRAM MEMORY
    BSF		EECON1,RD	    ;EE READ, NOT WRITE
    BANKSEL	EEDAT
    MOVF	EEDAT,w		    ;MOVE DATA AT DESIGNATED EE ADDR TO W
    MOVWF	INDF		    ;MOVE W TO VARIABLE IN RAM
    BANKSEL	STATIC_VARIABLES
    INCF	POSITION_RAM,F
    INCF	POSITION_EE,F
    BTFSS	POSITION_EE,4	    ;REPEAT 15 TIMES, FOR 15 VAR
    GOTO	EE_READ

Input_Loop_Timeout_Routine
	CALL	Compatibility_Function
	CALL	Initialize_MAX7219
	CALL	Update_LED_Display

Reinitialize_Timer0_for_Input_Loop_Timeout
	BANKSEL	OPTION_REG
	MOVLW	(0 << T0CS) | (0 << PSA) | (TIMER0_PRESCALAR << PS0)
	; select the instruction clock (Fosc/4), assign the prescalar
	; to Timer0, and set the prescalar value
	MOVWF	OPTION_REG
	BANKSEL	TMR0
	CLRF	TMR0
	BCF	INTCON, T0IE	; disable the Timer0 interupt
	BCF	INTCON, T0IF	; clear the Timer0 overflow flag

Input_Loop

	BANKSEL	TIME_ARRAY
	CLRF	TIME_ARRAY + 0
	BANKSEL	TEMP_ARRAY
	CLRF	TEMP_ARRAY + 0
	CLRF	TEMP_ARRAY + MAX_ARRAY_SIZE

	BTFSC	INTCON, T0IF
	GOTO	Input_Loop_Timeout_Routine

	BANKSEL	0x0
	BTFSC	PORTB, UP		    ;UP PB
	GOTO	UpCheck
    
	BTFSC	PORTB, DOWN		    ;DOWN PB
	GOTO	DownCheck
    
	BTFSC	PORTB, LEFT		    ;LEFT PB
	GOTO	LeftCheck

	BTFSC	PORTB, RIGHT		    ;RIGHT PB
	GOTO	RightCheck
    
	BANKSEL	STATIC_VARIABLES
	BTFSC	booleans_reg, START_BOOLEAN
	GOTO	Start_Active_Low
Start_Active_High
	BANKSEL	0x0
	BTFSC	PORTB, START
	GOTO	Start
	GOTO	Input_Loop
Start_Active_Low
	BANKSEL	0x0
	BTFSS	PORTB, START		    ;START PB
    	GOTO	Start
	GOTO	Input_Loop
   
UpCheck:
				    ;ARE YOU TRYING TO ADJUST 
				;1ST, 2ND, & 16TH DATAPOINTS?
    BCF		STATUS,Z	    ;IF SO, STOP IT.
    MOVLW	0X20		     
    SUBWF	datapoint,w
    BTFSC	STATUS,Z
    GOTO	Input_Loop
    BCF		STATUS,Z
    MOVLW	0X21
    SUBWF	datapoint,w
    BTFSC	STATUS,Z
    GOTO	Input_Loop
    BCF		STATUS,Z
    MOVLW	0X2F
    SUBWF	datapoint,w
    BTFSC	STATUS,Z
    GOTO	Input_Loop
    
    	    ;YOU FOLLOWED THE RULES. GOOD WORK.

;    BTFSC	datapoint,0	    ;ARE YOU ON A TIME INPUT?
;    GOTO	ImplementUp		    
;
;TimeCheckA:   
;    BCF		STATUS,C
;    BCF		STATUS,Z
;    MOVLW	0XFF
;    MOVWF	temp
;    MOVF	datapoint,w	    ;MOVE ADDR OF CURRENT DATAPOINT INTO IND ADDR 
;    MOVWF	FSR
;    MOVF	INDF,w
;    SUBWF	temp,w
;    BTFSS	STATUS,Z
;    GOTO	ImplementUp
;
;    MOVLW	.2		       
;    SUBWF	datapoint,w	    ;W HAS ADDR OF LAST TIME ENTRY
;    MOVWF	FSR		    ;MOVE ADDR OF LAST TIME ENTRY INTO IND ADDR
;    MOVF	INDF,w		    ;LastTime HAS VALUE OF LAST TIME ENTRY
;    MOVWF	LastTime
;    MOVF	datapoint,w
;    MOVWF	FSR
;    MOVF	LastTime,w
;    MOVWF	INDF
;    CALL	Write_Datapoint_to_LEDs
;    GOTO	Input
;       
;ImplementUp:	    
    MOVF	datapoint,w	    ;MOVE ADDR OF CURRENT DATAPOINT INTO IND ADDR 
    MOVWF	FSR
    INCF	INDF,F		    ;INCREMENT VALUE AT CURRENT DATAPOINT ADDR
	CALL	Update_LED_Display
	Waste_Time	.255, .255, .1
    GOTO	Input_Loop
    
DownCheck:			    ;ARE YOU TRYING TO ADJUST 
				    ;1ST, 2ND, & 16TH DATAPOINTS?
    BCF		STATUS,Z	    ;IF SO, STOP IT.
    MOVLW	0X20		     
    SUBWF	datapoint,w
    BTFSC	STATUS,Z
    GOTO	Input_Loop
    BCF		STATUS,Z
    MOVLW	0X21
    SUBWF	datapoint,w
    BTFSC	STATUS,Z
    GOTO	Input_Loop
    BCF		STATUS,Z
    MOVLW	0X2F
    SUBWF	datapoint,w
    BTFSC	STATUS,Z
    GOTO	Input_Loop
    
    	    ;YOU FOLLOWED THE RULES. GOOD WORK.
    
    BTFSC	datapoint,0	    ;ARE YOU ON A TIME INPUT?
    GOTO	ImplementDown	    ;IF NOT, HURRY UP AND GET IMPLEMENTED
        
TimeCheck:    
    BCF		STATUS,C
    BCF		STATUS,Z
    MOVLW	.2		       
    SUBWF	datapoint,w	    ;W HAS ADDR OF LAST TIME ENTRY
    MOVWF	FSR		    ;MOVE ADDR OF LAST TIME ENTRY INTO IND ADDR
    MOVF	INDF,w		    ;LastTime HAS VALUE OF LAST TIME ENTRY
    MOVWF	LastTime
    MOVF	datapoint,w	    ;MOVE ADDR OF CURRENT TIME ENTRY INTO IND ADDR
    MOVWF	FSR
    MOVF	INDF,w		    ;W HAS VALUE OF CURRENT TIME ENTRY
    SUBWF	LastTime,w	    ;COMPARE TIMES
    BTFSS	STATUS,C	    ;IF CURRENT TIME < LAST TIME
    BTFSC	STATUS,Z	    ;OR IF CURRENT TIME = LAST TIME 
    GOTO	Input_Loop	    ;DON'T ADJUST TIME
    
ImplementDown:
    MOVF	datapoint,w	    ;MOVE ADDR OF CURRENT DATAPOINT INTO IND ADDR 
    MOVWF	FSR
    DECF	INDF,F		    ;DECREMENT VALUE AT CURRENT DATAPOINT ADDR
	CALL	Update_LED_Display
	Waste_Time	.255, .255, .1
	GOTO	Input_Loop
    
LeftCheck:			    ;ARE YOU TRYING TO MOVE
				    ;BEFORE THE 1ST DATAPOINT?
    BCF		STATUS,Z	    ;WHAT ARE YOU? A TIME-TRAVELLER?
    MOVLW	0X20		    
    SUBWF	datapoint,w	    
    BTFSC	STATUS,Z
    GOTO	Input_Loop	    ;YOU CAN'T SAVE THE DINOSAURS. STOP IT.
    
    	    ;YOU FOLLOWED THE RULES. GOOD WORK.
	    
    DECF	datapoint,F
	CALL	Update_LED_Display
	Waste_Time	.255, .255, .2
	GOTO	Input_Loop
    
RightCheck:			    ;ARE YOU TRYING TO MOVE
				    ;PAST THE 16TH DATAPOINT?
    BCF		STATUS,Z	    ;ANOTHER TIME-TRAVELLER, HUH?
    MOVLW	0X2F		    
    SUBWF	datapoint,w	    
    BTFSC	STATUS,Z
    GOTO	Input_Loop	    ;GET OUTTA HERE, MARTY MCFLY. STOP IT.
    
    	    ;YOU FOLLOWED THE RULES. GOOD WORK.
	    
	INCF	datapoint,F
	CALL	Update_LED_Display
	Waste_Time	.255, .255, .2
	GOTO	Input_Loop
    
Start

Reinitialize_Timer0
	BANKSEL	OPTION_REG
	BCF	OPTION_REG, T0CS; select instruction clock Fosc/4
	BCF	OPTION_REG, PSA	; assign prescalar to Timer 0
	BCF	OPTION_REG, PS2	; Set PS<2:0> to 000, corresponding
	BCF	OPTION_REG, PS1	; to a prescalar of 2
	BCF	OPTION_REG, PS0
	BANKSEL	INTCON
	BCF	INTCON, T0IE	; disable the Timer0 interupt

Check_Door_Contact_Switch
	BANKSEL	PORTA
	BTFSS	PORTA, HEAT	; if door is shut, HEAT pin will be pulled low
	GOTO	Door_Closed
Door_Open	; Beap three times then return to input loop
	BANKSEL	TRISA
	BCF	TRISA, ALARM
	BANKSEL	STATIC_VARIABLES
	MOVLW	.3
	MOVWF	time_counter_H
	CALL	Time_Counting_Loop
	BANKSEL	TRISA
	BSF	TRISA, ALARM
	BANKSEL	STATIC_VARIABLES
	MOVLW	.3
	MOVWF	time_counter_H
	CALL	Time_Counting_Loop
	BANKSEL	TRISA
	BCF	TRISA, ALARM
	BANKSEL	STATIC_VARIABLES
	MOVLW	.3
	MOVWF	time_counter_H
	CALL	Time_Counting_Loop
	BANKSEL	TRISA
	BSF	TRISA, ALARM
	BANKSEL	STATIC_VARIABLES
	MOVLW	.3
	MOVWF	time_counter_H
	CALL	Time_Counting_Loop
	BANKSEL	TRISA
	BCF	TRISA, ALARM
	BANKSEL	STATIC_VARIABLES
	MOVLW	.3
	MOVWF	time_counter_H
	CALL	Time_Counting_Loop
	BANKSEL	TRISA
	BSF	TRISA, ALARM

	GOTO	Interupt_Vector
Door_Closed




;WRITE ALL POINTS TO EEPROM
    MOVLW	0X20
    BANKSEL	POSITION_RAM
    MOVWF	POSITION_RAM
    CLRF	POSITION_EE
EE_WRITE: 
    MOVF	POSITION_RAM,w
    MOVWF	FSR
    MOVF	POSITION_EE,w    
    
    BANKSEL	EEADR
    MOVWF	EEADR		    ;EEPROM ADDRESS
    MOVF	INDF,w		    ;TO READ
    MOVWF	EEDAT
    BANKSEL	EECON1
    BCF		EECON1,EEPGD	    ;POINT TO DATA MEMORY, NOT PROGRAM MEMORY
    BSF		EECON1,WREN	    ;ENABLE WRITE
    BCF		INTCON,GIE	    ;DISABLE INT
    BTFSC	INTCON,GIE	    ;SEE AN576
    GOTO	$-2
    MOVLW	0X55		    ;!!!!!!REQUIRED SEQUENCE!!!!!!
    MOVWF	EECON2		    ;NO IDEA WHAT IS HAPPENING
    MOVLW	0XAA		    ;EECON2 ISN'T EVEN REAL
    MOVWF	EECON2		    ;THIS IS BS 
    BSF		EECON1,WR	    ;SET WR BIT TO BEGIN WRITE
    BSF		INTCON,GIE	    ;ENABLE INT
    BANKSEL	delay1
    CLRF	delay1
    CLRF	delay2
DELAY:				    ;WAIT FOR WRITING TO FINISH
    DECFSZ	delay1
    GOTO	DELAY
    DECFSZ	delay2
    GOTO	DELAY
    BANKSEL	EECON1
    BCF		EECON1,WREN	    ;DISABLE WRITES
    
    BANKSEL	POSITION_EE
    INCF	POSITION_RAM,F
    INCF	POSITION_EE,F
    BTFSS	POSITION_EE,4	    ;REPEAT 15 TIMES, FOR 15 VAR
    GOTO	EE_WRITE	

Turn_on_Fan
	BANKSEL	PORTC
	BSF	PORTC, MOTOR_ON

Initialize_Runtime_and_Data_Index
	BANKSEL	STATIC_VARIABLES
	CLRF_X	time, UINT16_T
	CLRF	data_index

Control_Loop
	
	; Reset Timer 0
	BANKSEL	TMR0
	MOVLW	(.256 - TMR0_PERIOD)	; (because TMR0 increments until it overflows)
	MOVWF	TMR0			; Start timing
	BCF	INTCON, T0IF		; and Clear the Timer Interupt Flag

	; Reset the Variables for Timer Overflow Counting
	BANKSEL	STATIC_VARIABLES	
	CLRF	time_counter_L
	MOVLW	TIME_COUNTER_SET_VALUE
	MOVWF	time_counter_H	

	; Measure the Thermocouple Analog Input
	BANKSEL	ADCON0
	BSF	ADCON0, CHS0	; select analog channel 1 (CHS<3:0> = 0001)
	BCF	ADCON0, CHS1
	BCF	ADCON0, CHS2
	BCF	ADCON0, CHS3	
	BSF	ADCON0, ADON	; enable ADC
	NOP			; wait 5us aquisition time, based on small Rout
	NOP			; of op-amp and Tacq equation on page 111 of datasheet
	NOP
	NOP
	NOP
	BSF	ADCON0, GO	; start ADC conversion
	BTFSC	ADCON0, GO	; is conversion done?
	GOTO	$-1		; Estimated completion time is (Fosc/8) * 11
	BANKSEL	ADRESH
	MOVF	ADRESH, W	; save result to Temp register. No additional math is
	BANKSEL	STATIC_VARIABLES;   necessary because the op-amp gain was selected
	MOVWF	Temp		; to match the full range of the ADC to 255 degrees delta T

	; Wait for Timer0 to Maintain Accurate Timing
	BTFSS	INTCON, T0IF	; Test for Timer Overflow (note INTCON is in all banks)
	GOTO	$-1
	BCF	INTCON, T0IF
	BANKSEL	TMR0
	MOVLW	(.255 - TMR0_PERIOD)	; Reset TMR0

	; Measure the Temperature Reference Analog Input

	; Calculate Absolute Temperature

	; Wait for Timer 0 to Maintain Accurate Timing

	; Update LED Display 
	BANKSEL	STATIC_VARIABLES
	BCF	booleans_reg, TT_BOOLEAN	; (assume it is time for time to be displayed)
	BTFSC	time, 0		; test if time or temperature should be displayed
	BSF	booleans_reg, TT_BOOLEAN	; (alternate every second)
	CALL	Update_LED_Display

	; Wait for Timer 0 to Maintain Accurate Timing

	CALL	Time_Counting_Loop

Increment_Time_and_Continue_to_Next_Iteration
	BANKSEL	STATIC_VARIABLES
	INCF	(time)
	BTFSC	STATUS, Z
	INCF	(time + 1)	
	GOTO	Control_Loop
	


    end
