benlorenzetti/Breadboard-Oven/(commit log)

2015-11-08 started bom with user interface components
    [BOM.ods]
2015-11-10 user interface text and temperature objectives
2015-11-11 LED display, std temp profile, and oven concept figures added
2015-11-13 heat conduction in 1d design equations
2015-11-14 cooling law heat transfer coefficients
2015-11-14 chamber air heat capacity
2015-11-14 edited text in chamber capacity and completed thermal properties table
2015-11-17 simple nichrome wire model
2015-11-17 nichrome properties table and PCB trace width
2015-11-20 temperature feedback circuit
    [BOM.ods, Easy-PCB.kicad_pcb, Easy-PCB.sch, Temperature-Feedback.sch]
2015-11-21 aluminum components added to BOM and kicad library for 7-seg ICs
    [BOM.ods, Front-PCB.kicad_pcb, Front-PCB.sch, Temperature-Feedback.sch]
2015-11-21 Temperature feedback design
2015-11-21 user interface design section
    [BOM.ods]
2015-11-21 relays and flyback diodes
    [BOM.ods]
2015-11-22 motor driver section
2015-11-22 diagrams for heat circuit and control system added
2015-11-23 safety switch components added to bom and kicad lib
    [BOM.ods]
2015-11-23 front PCB schematic complete
    [Front-PCB.sch]
2015-11-25 front panel erc
    [BOM.ods, Front-PCB.sch]
2015-11-25 kicad footprints and unrouted layout
    [BOM.ods, Front-PCB.sch]
2015-11-26 front panel pcb routing complete
    [Front-PCB.kicad_pcb, Front-PCB.sch]
2015-11-28 nichrome mounting parts added to bom and feedback terminal block removed
    [BOM.ods, Easy-PCB.sch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]
2015-11-28 motor driver edits
2015-11-28 Motor Driver BOM
    [BOM.ods]
2015-11-28 user interface updated with piezo alarm
    [BOM.ods]
2015-11-29 power circuit requirements section
    [BOM.ods, Easy-PCB.sch]
2015-11-29 some of power circuit bom
    [BOM.ods]
2015-11-29 fixed nichrome wire resistance calculation and more power circuit bom
    [BOM.ods]
2015-11-30 several edits to report
    [BOM.ods]
2015-12-04 SPI functioning with display driver and 7-seg lookup table complete
    [BOM.ods]
2015-12-05 LED display function working and semi-merged with adams code
2015-12-05 before sending assembly to adam
2015-12-06 front PCB assembled and problems recorded in TODO
    [easy-pcb.asm]
2015-12-06 interupt routing and timer0 outline complete
2015-12-07 Update_LED_Display() temperature portion complete
2015-12-08 display function debugged with multibyte times
    [BOM.ods]
2015-12-09 thermocouple and runtime temperature/time display working
2015-12-11 some text edits and controller and thermocouple circuit diagrams
2015-12-11 inputted most of BOM
    [BOM.csv]
2015-12-14 bom updates: relay resistors and motor connectors
2015-12-17 motor circuit working and switched to Fosc=8MHz...which is causing some pushbutton bugs
    [easy-pcb.asm]
2015-12-17 motor variables speed macro and data memory organization macro
2015-12-18 edited introduction and started redo of motor driver design and 12 and 24 v rails
2015-12-22 updated circuit diagrams and started mechanical drawings
    [Fan-Drive.dwg]
2015-12-24 adafruit and NMB motors front views
    [Fan-Drive.dwg]
2015-12-26 updated temperature feedback schematic
    [Easy-PCB.sch, Heat-Relay.sch, Temperature-Feedback.sch]
2015-12-27 heat relay schematic and relay part updated-but not math in design section
    [Easy-PCB.sch, Temperature-Feedback.sch]
2015-12-28 rather poorly written relay driver section
2015-12-28 microcontroller schematic kicad
    [Easy-PCB.sch]
2015-12-28 kicad motor and speaker schematics
    [Easy-PCB.sch, Heat-Relay.sch, Motor-Driver.sch, Temperature-Feedback.sch]
2015-12-29 power circuit schematic in kicad
    [Easy-PCB.sch, Heat-Relay.sch, Motor-Driver.sch, Power-Circuit.sch, Temperature-Feedback.sch]
2015-12-29 controller board schematic complete
    [Analog-Math.sch, Easy-PCB.sch, Heat-Relay.sch, Motor-Driver.sch, Power-Circuit.sch, Temperature-Feedback.sch]
2015-12-29 HeatOn fix, replaced R1-8 with array
    [Analog-Math.sch, Easy-PCB.sch, Heat-Relay.sch, Motor-Driver.sch, Power-Circuit.sch, Temperature-Feedback.sch]
2015-12-31 motor driver design
    [Motor-Driver.sch, Power-Circuit.sch]
2015-12-31 kicad resistor package associations complete
    [Analog-Math.sch, Easy-PCB.sch, Heat-Relay.sch, Motor-Driver.sch, Temperature-Feedback.sch]
2016-01-01 capacitors and diode part associations
    [Analog-Math.sch, Easy-PCB.sch, Heat-Relay.sch, Motor-Driver.sch, Power-Circuit.sch]
2016-01-02 temperature feedback resistor design
    [Temperature-Feedback.sch]
2016-01-02 IC BOM and footprints complete
    [Analog-Math.sch, Easy-PCB.sch, Motor-Driver.sch, Power-Circuit.sch, Temperature-Feedback.sch]
2016-01-03 footprint associations complete
    [Easy-PCB.sch, Heat-Relay.sch, Motor-Driver.sch, Power-Circuit.sch]
2016-01-03 errors cleared and components on board
    [Analog-Math.sch, Easy-PCB.sch, Power-Circuit.sch]
2016-01-05 power port, switch, transformer, and relay in place
    [Easy-PCB.kicad_pcb, Heat-Relay.sch]
2016-01-05 power supply placed and routed
    [Easy-PCB.kicad_pcb, Easy-PCB.sch, Heat-Relay.sch, Power-Circuit.sch]
2016-01-06 power transistors mostly in place
    [Easy-PCB.kicad_pcb]
2016-01-06 motor circuit routed
    [Analog-Math.sch, Easy-PCB.kicad_pcb, Easy-PCB.sch, Heat-Relay.sch, Motor-Driver.sch, Power-Circuit.sch, Temperature-Feedback.sch]
2016-01-07 reconfigured motor driver routing
    [Easy-PCB.kicad_pcb, Easy-PCB.sch]
2016-01-19 most of temperature feedback in place
    [Easy-PCB.kicad_pcb]
2016-01-21 connector to front PCB routed
    [Easy-PCB.kicad_pcb, Easy-PCB.sch, Heat-Relay.sch]
2016-01-23 routing complete
    [Analog-Math.sch, Easy-PCB.kicad_pcb, Easy-PCB.sch, Heat-Relay.sch, Motor-Driver.sch, Power-Circuit.sch, Temperature-Feedback.sch]
2016-01-24 added mounting cutouts to driver board
    [Easy-PCB.kicad_pcb]
2016-02-01 new display driver, rot encoder, and stop button for front-facing pcb
2016-02-04 electronics BOM updated
    [Easy-PCB-B.Cu.gbl, Easy-PCB-B.Mask.gbs, Easy-PCB-B.SilkS.gbo, Easy-PCB-Edge.Cuts.gm1, Easy-PCB-F.Cu.gtl, Easy-PCB-F.Mask.gts, Easy-PCB-F.SilkS.gto, Easy-PCB.drl]
2016-03-19 updated schematic pdfs
